ionhs/Escornabot-2.12/Software/arduino-1.4.3/arduino-1.4.3/README.md

# Arduino firmware for Escornabot



This is the Arduino firmware to upload to the Escornabot.

__More info about the Escornabot at [escornabot.com][ESC01]__

Please, [open issues here][ISS01] if you find any problem with this firmware. Thank you!

## Download

Download the __[last version from here](https://github.com/escornabot/arduino/releases/latest)__

It is preconfigured to run with the last stable [EscornaCPU board][ELE01]. If 
you don't have one or you are not sure, copy the most appropriate 
_Configuration.h_ from [_config_ subdirectories](config). 

    cp config/<escornaboard>/Configuration.h Escornabot/Configuration.h

Please, send us other board configurations if you have produced your own
electronic board and it is publicy available.

## Instructions

### Full guide

To configure and load the firmware, please, follow the [official guide][GUI01].

### Compilation and upload with PlatformIO

You only need to install [PlatformIO CLI][PIO01]:

    pip install -U platformio

There is a project file _platformio.ini_ to compile and upload escornabot
firmware to the Atmel AVR platform + Arduino framework for Arduino Nano and
Arduino Micro boards.

#### Arduino Nano

    # compile firmware and upload firmware to an Arduino Nano:
    pio run -e nano -t upload

#### Arduino Micro

    # compile firmware and upload firmware to an Arduino Micro:
    pio run -e micro -t upload

#### More boards

Please, send us new configurations if you test Escornabot in another board :)

## Branches and releases

Escornabot's repository flows through 2 main branches: 

- [stable][STA01]: well-tested firmware that you usually have to work with.
  Released versions are named with even minor numbers (x.0, x.2, ...).
- [testing][TES01]: new features and minor bugs pending of testing in deep.
  Released versions are named with odd minor numbers (x.1, x.3, ...).

<!-- links -->
[ELE01]: https://github.com/escornabot/electronics
[BRI01]: https://github.com/escornabot/arduino/releases/tag/v1.2-brivoi
[ESC01]: http://escornabot.com
[GUI01]: http://escornabot.com/web/en/content/configure-and-load-firmware
[ISS01]: https://github.com/escornabot/arduino/issues
[PIO01]: http://platformio.org/get-started/cli
[PLA01]: https://github.com/escornabot/arduino/releases/tag/v1.1-placidus
[STA01]: https://github.com/escornabot/arduino/tree/stable
[TES01]: https://github.com/escornabot/arduino/tree/testing
[VER201606]: https://github.com/escornabot/arduino/releases/tag/v1.3.1
[VER201608]: https://github.com/escornabot/arduino/releases/tag/v1.3.2
