ionhs/Escornabot-2.12/Recopilación/escornabot-v2.12-master (1)/escornabot-v2.12-master/README.md

# escornabot-v2.12 
  
En este repositorio encontrarás lo necesario para poder fabricar la versión v2.12 con la placa creada por XDeSIG. Es la evolución de la versión DIY.

Material recopilado de [Rafa Couto](https://github.com/rafacouto) y [XDeSIG](https://github.com/xdesig)
  
Web oficial del robot escornabot http://escornabot.com
  


# Piezas Impresas3D Necesarias
  
Descripción         | imagen          | archivo         
------------- | ------------- | ------------- 
Sujeción bola v2|ballcaster-v2.stl | [ballcaster-v2.stl](archivos-stl/ballcaster-v2.stl)  
Sujeción batería|battery-bracket.stl | [battery-bracket.stl](archivos-stl/battery-bracket.stl)  
Sujeción motores|MotorBracket.stl | [MotorBracket.stl](archivos-stl/MotorBracket.stl)   
Sujeción placa botonera|escornacpu-2_10-bracket.stl | [escornacpu-2_10-bracket.stl](archivos-stl/Addon-KeypadBracket-PCB.stl)  
Rueda izquierda|wheel-l.stl | [wheel-l.stl](archivos-stl/wheel-l.stl)  
Rueda derecha|wheel-r.stl | [wheel-r.stl](archivos-stl/wheel-r.stl)

# Guía soldadura componentes
  
Para esta versión tienes una guía de soldadura creada por XDeSIG donde puedes ver cada componente en tres idiomas:

- [Guía Gallego](https://drive.google.com/file/d/0B8qe5ux0eH6Ca1RxaEpXN0RBNzQ/view) 
- [Guía Castellano](https://drive.google.com/file/d/1LsLHT4FGi4LXgHwbQ9Av0ggsQkUQL7MU/view)  
- [Guía Catalán](https://drive.google.com/file/d/1ZNXCGC65Pyris7Z-aMvKBDYPzR_YNUv_/view)  

Si eres de los que no les gusta complicarse, puedes pedir tu kit abriendo un tema nuevo en el grupo de google, te dejo link donde XDeSIG explica las diferentes opciones que tienes [pincha aquí](https://groups.google.com/forum/#!topic/escornabot_users/paQGTPHzNTQ)
  
  

# Guía montaje
  
También tienes un .pdf para descargar la [guía de montaje del cuerpo](https://goo.gl/3XQ8nM)

# Características de la placa
  
Los más curiosos pueden consultar todas las [características de la placa](https://drive.google.com/file/d/0B8qe5ux0eH6CQ1dsNGh2UFJvdnNqRUhfakRvUjZVejFtQ2dF/view)  
  
