ionhs/Escornabot-2.12/Boom.md

| Componente | nº | Link | Observaciónes | Comprado |
| --- | ---- | --- | --- | --- |
| Motor 28BYJ-48 (sin ULN2003 driver) | 2 | https://es.aliexpress.com/item/Frees-hipping-5V-4-Phase-Stepper-Step-Motor-Driver-Board-ULN2003-with-drive-Test-Module-Machinery/32706559510.html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 | Para la versión 2.12 no hace falta comprar el driver ULN2003 | Sí |
| Cable USB | 1 | | Cable Mini-B USB >> USB | No |
| Diodo Schottky | 1 | https://es.aliexpress.com/item/1N4007-1N4148-1N5819-1N5399-1N5408-1N5822-FR107-FR207-8-valores-100-piezas-componentes-electr-nicos-paquete/32856981814.html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 | La mayoría de los diodos valen. Algunos han usado el 1N4007 que no es Schottky | Sí |
| Arduino NANO Atmega328 | 1 | https://es.aliexpress.com/item/Nano-V3-ATmega328-CH340G-Micro-USB-Pin-headers-NOT-soldered-Compatible-for-Arduino-Nano-V3-0/32664577152.html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 | Es el diseño RobotDyn que lleva un regulador de 3.3v | Sí |
| Buzzer 5V | 1 | https://es.aliexpress.com/item/Free-Shipping-10pcs-Electromagnetic-buzzer-5V-5V-active-buzzer/635190995.html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 | | Sí |
| Interruptor SK-12D07 o SK-12F14 | 1 | https://es.aliexpress.com/item/Nueva-llegada-10-unids-lote-interruptor-SK12D07VG3-Stents-peque-o-interruptor-de-palanca-3mm-alta-miniatura/32918136229.html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 | Cualquiera de los 2 interruptores valen, este es el SK12D07  | Sí |
| Fusible autoarmable RXEF050 XF050 72v 0.5A | 1 | https://es.aliexpress.com/item/10-PCSlot-fusible-recuperaci-n-auto-RXEF050-XF050-72-v-0-5A-PPTC/32896526801.html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 | | Sí |
| Tiras de 40 pines machos/hembras | 2 | https://es.aliexpress.com/item/Promotion-5-PCS-Pack-40-Pin-2-54mm-Single-Row-Straight-Male-Female-Pin-Header-Strip/32598438788.html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 | | Sí |
| ULN2803 | 1 | https://es.aliexpress.com/item/10pcs-lot-ULN2803APG-ULN2803-DIP-18-Octal-High-Voltage-High-Current-Darlington-Transistor-Arrays/32817793114.html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 | | Sí |
| Zócalo DIP-18 | 1 | https://es.aliexpress.com/item/10pcs-Round-Hole-18-Pins-2-54MM-DIP-18-PIN-IC-Sockets-Adaptor-Solder-Type-IC/32805504735.html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 | Con las patas redondeadas es más robusto | Sí |
| Pulsadores con botón colores (blanco, negro, rojo, verde y azul) | 5 | https://es.aliexpress.com/item/100pcs-Plastic-Tactile-Switch-PCB-Tact-Push-Button-Momentary-Switch-4-Pins-5-Color-Button-Cap/32826994795.html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 | OJO han envio amarillo en vez de negro. Tras reclamar/pelearlo ha devuelto 1 dolar. | Sí |
| Led diodos 3mm (blanco, rojo, verde y azul) | 4 | https://es.aliexpress.com/item/500pcs-3-mm-Super-Bright-High-Brightness-5-Colors-Red-Green-Blue-Yellow-White-Mini-Diffused/1936229691.html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 | | Sí |
| Conectores macho XH2.54 de 2 pines | 2 | https://es.aliexpress.com/item/XH2-54-conector-pin-Header-macho-material-2-54mm-pitch-XH-A-2-P-3-P/32848821355.html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 | | Sí |
| Condensadores 100nF | 2 | | El encapsulado debe ser del tipo lenteja pequeña para que encaje. Al no tener he puesto smd | No |
| Resistencia 1K | 4 | | 0,25w | No |
| Resistencia 10K | 8 | | 0,25w | No |
| Resistencia 18K | 1 | | 0,25w | No |
| Resistencia 22K | 1 | | 0,25w | No |
| Conector 2 pines con tornillo | 1 | | Las dimensiones de los pads son raras para ese tipo de conector. He tenido que poner un molex de 90º que tenía | No |
| Jumper 2 pines 2.54 | 1 | https://es.aliexpress.com/store/product/100pcs-Pin-Header-Jumper-blocks-Connector-2-54-mm-for-3-1-2-Hard-Disk-Drive/4388017_32907886777.html | | No |
| Tornillos M3x5 | ? | | | No |
| Tornillos M3x15 | ? | | | No |
| Tuerca M3 | 2 | | | No |
| Portapilas R6 4 pilas AA | 1 | https://www.ebay.es/itm/PORTAPILAS-4x-2-2-AA-R6-6v-con-cable-alimentacion-PCB-battery-holder/321578227852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 | | Si |
| Canica diametro 14mm | 1 | https://es.aliexpress.com/item/40-pcs-14mm-Mixed-Smiling-Face-Smile-Round-Ball-Spacer-Beads-Plastic-Acrylic-For-DIY-Necklace/32699472196.html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 | Aunque son bolas para bisutería funcionan bien | Si |
| Junta tórica 63x57x3mm | 2 | https://es.aliexpress.com/item/Electronic-Component-Red-O-Ring-62mm-x-56mm-x-3mm-O-Ring-Washer-Seals-Assortment/32371865042.html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 | | Si |
| PCB escornabot 2.12 | 1 | | | Si |
