ionhs/Escornabot-2.12/Recopilación/electronics-master (2)/electronics-master/providers/PCBWay.pdf

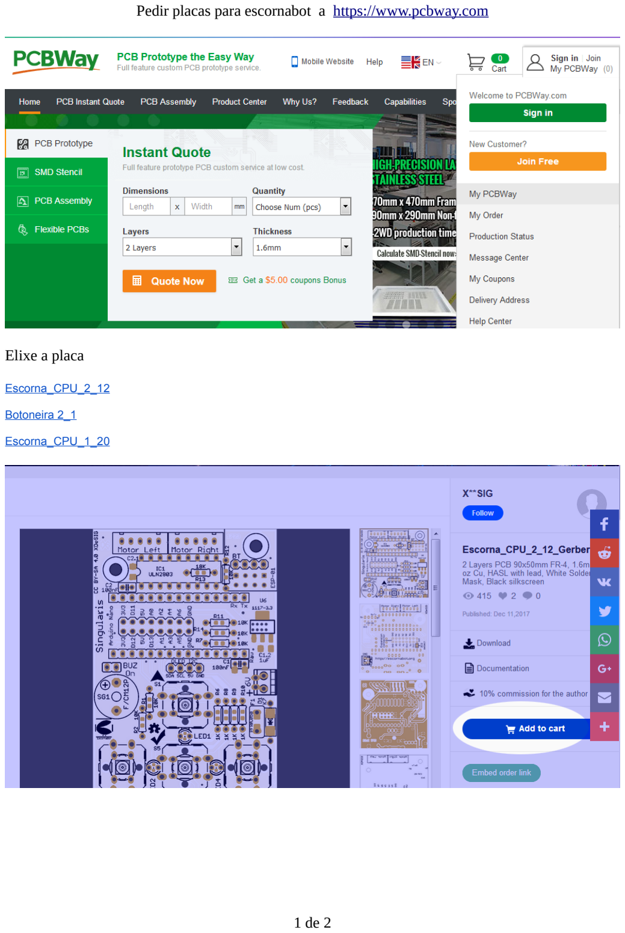
[picture p12: page 1]

Pedir placas para escornabot a https://www.pcbway.com

Elixe a placa

Escorna_CPU_2_12 (https://www.pcbway.com/project/shareproject/W50475ASN19_Escorna_CPU_2_12_Gerber.html)

Botoneira 2_1 (https://www.pcbway.com/project/shareproject/W50475ASN5_Escorna_bot_2_1_Gerber.html)

Escorna_CPU_1_20 (https://www.pcbway.com/project/shareproject/W50475ASN23_Escorna_CPU_1_20.html)

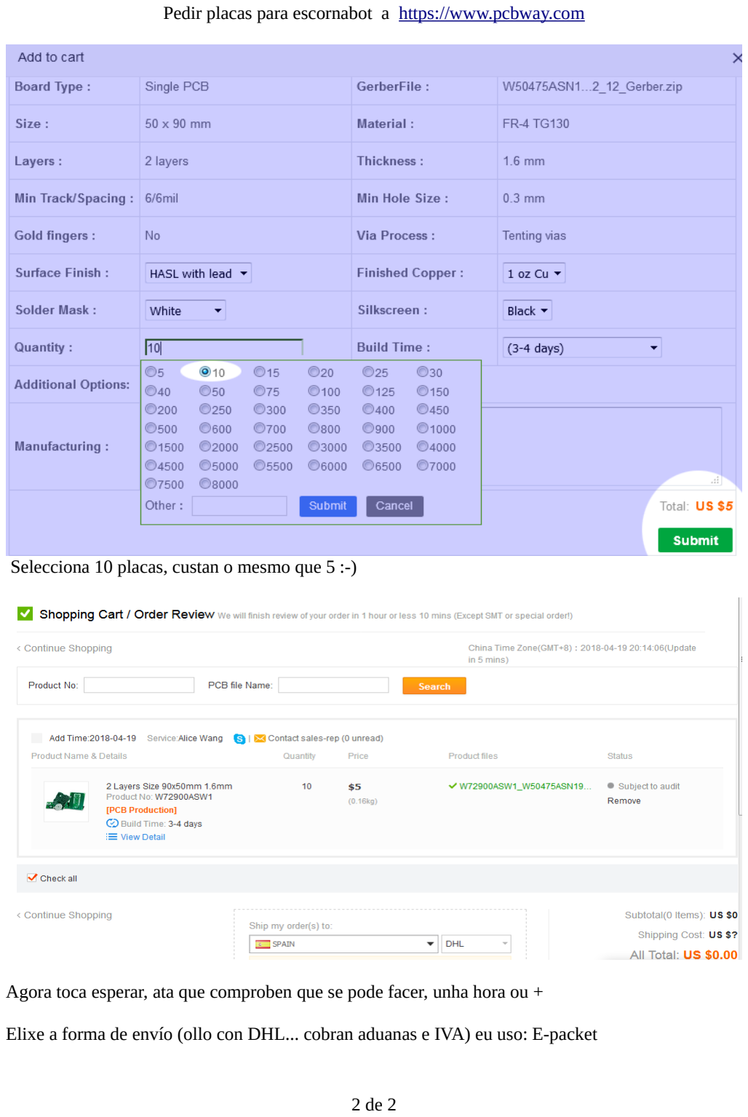
[picture p13: page 2]

Pedir placas para escornabot a https://www.pcbway.com

Selecciona 10 placas, custan o mesmo que 5 :-)

Agora toca esperar, ata que comproben que se pode facer, unha hora ou +

Elixe a forma de envío (ollo con DHL... cobran aduanas e IVA) eu uso: E-packet
