ionhs/Escornabot-2.12/Recopilación/electronics-master (2)/electronics-master/Keypad/E_KEYPAD_2.0D/Escorna_Shield_botoneira_2_0D_CI_bot.pdf

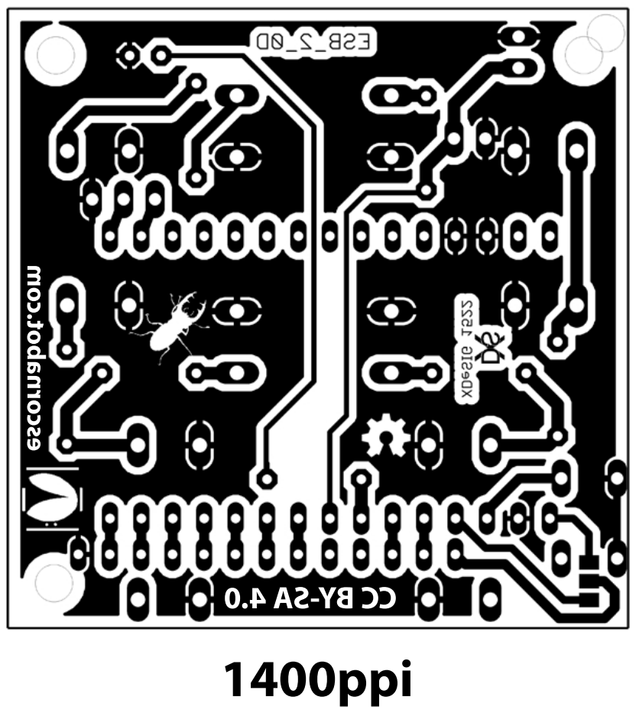
[picture p25: page 1]

escornabot.com

1

4

0

0

p

p

i
