ionhs/Escornabot-2.12/Recopilación/electronics-master (2)/electronics-master/EscornaCPU/2.x/2.01/Escorna_CPU_2_01_Photolit.pdf

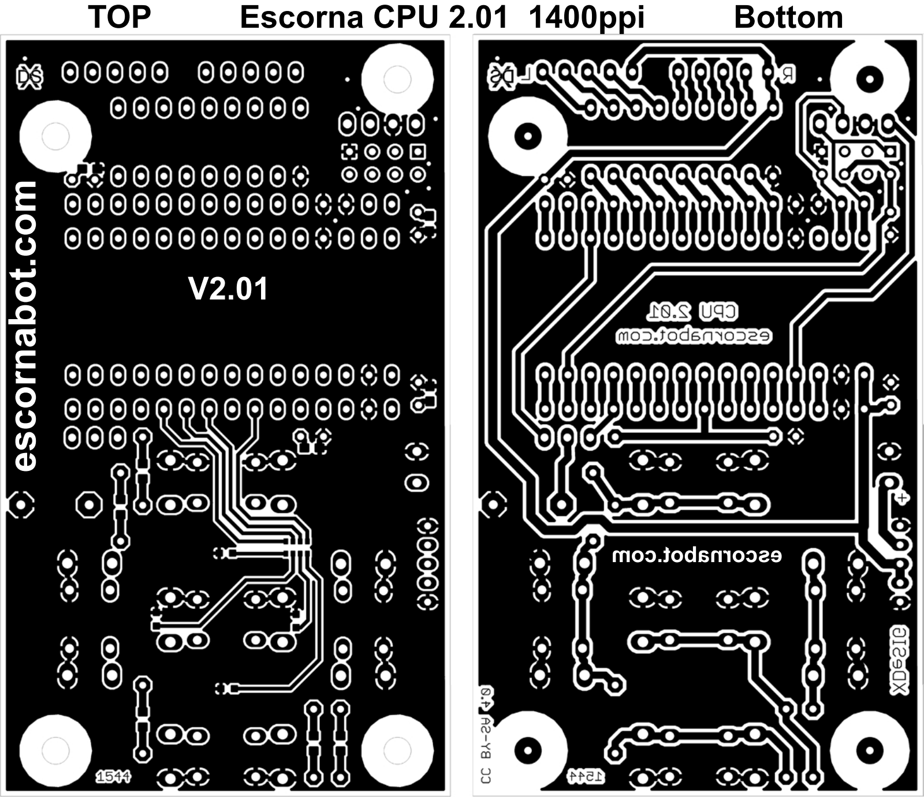
[picture p26: page 1]

e

s

c

orn

a

b

ot.c

o

m

TOP | EscornaCPU2.011400ppi | Bottom

V2.01
