ionhs/Escornabot-2.12/imagenes/ballcaster-v2.png

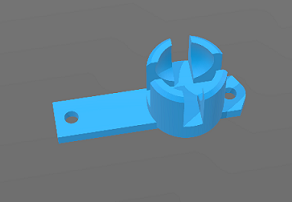
imagenes/ballcaster-v2.png
