ionhs/Escornabot-2.12/imagenes/battery-bracket.png

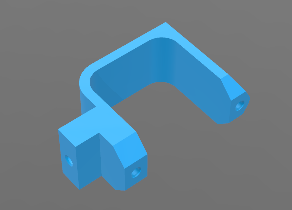
imagenes/battery-bracket.png
