ionhs/Escornabot-2.12/imagenes/escornabot-v212.jpg

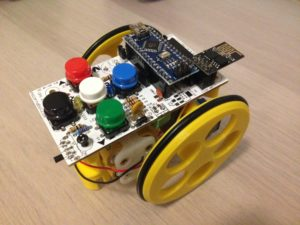
imagenes/escornabot-v212.jpg
