ionhs/Escornabot-2.12/imagenes/escornacpu-2_10-bracket.png

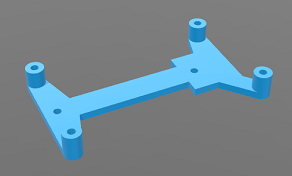
imagenes/escornacpu-2_10-bracket.png
