ionhs/Escornabot-2.12/imagenes/MotorBracket.png

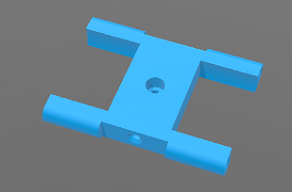
imagenes/MotorBracket.png
