ionhs/Escornabot-2.12/imagenes/piezas-v212.JPG

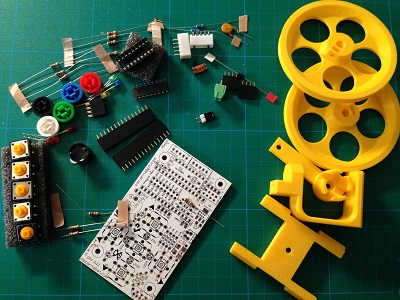
imagenes/piezas-v212.JPG
