ionhs/Escornabot-2.12/imagenes/placas-v212.jpg

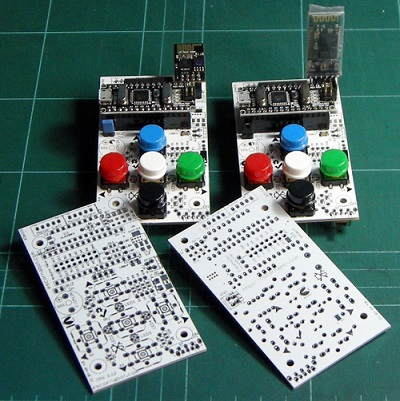
imagenes/placas-v212.jpg
