ionhs/Escornabot-2.12/imagenes/wheel-l.png

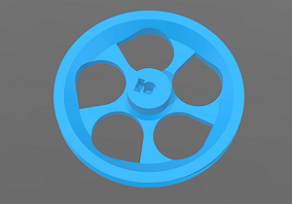
imagenes/wheel-l.png
