ionhs/Escornabot-2.12/imagenes/wheel-r.png

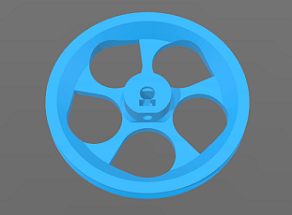
imagenes/wheel-r.png
