ionhs/Escornabot-2.12/Recopilación/electronics-master (2)/electronics-master/ArduinoShield/BotMotShielArdu.jpg

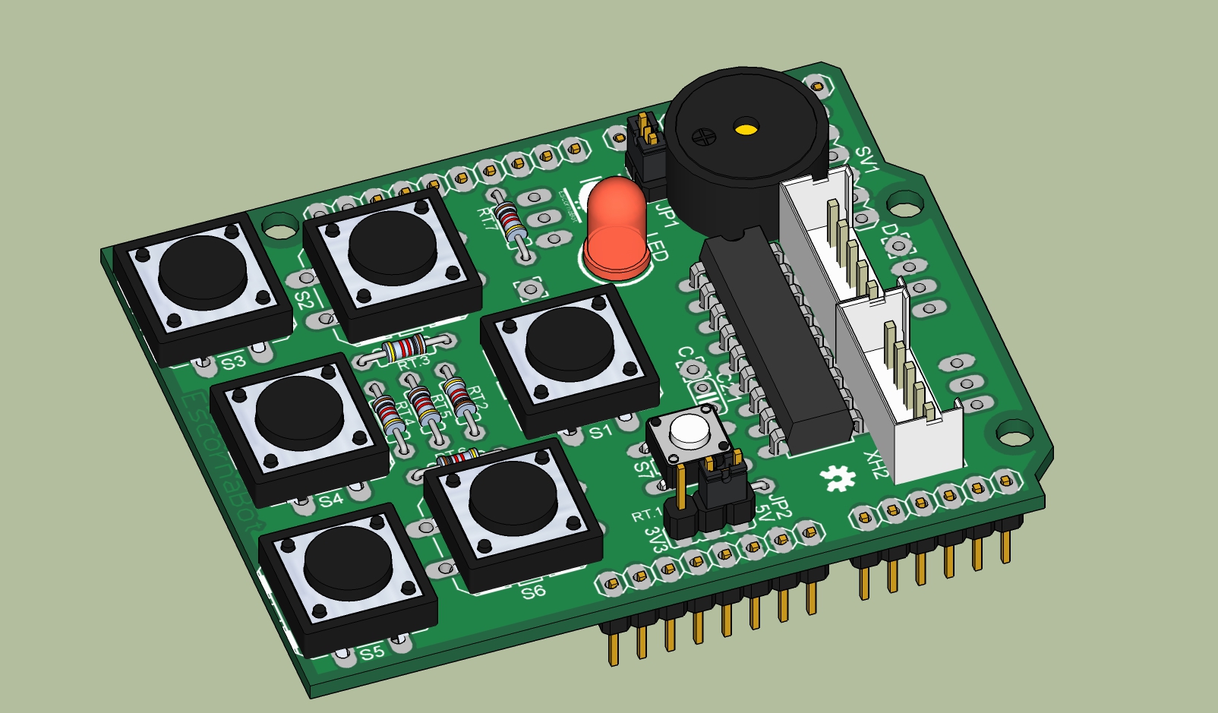
Recopilación/electronics-master (2)/electronics-master/ArduinoShield/BotMotShielArdu.jpg
