ionhs/Escornabot-2.12/Recopilación/electronics-master (2)/electronics-master/ArduinoShield/BotMotShielArdu_serig.png

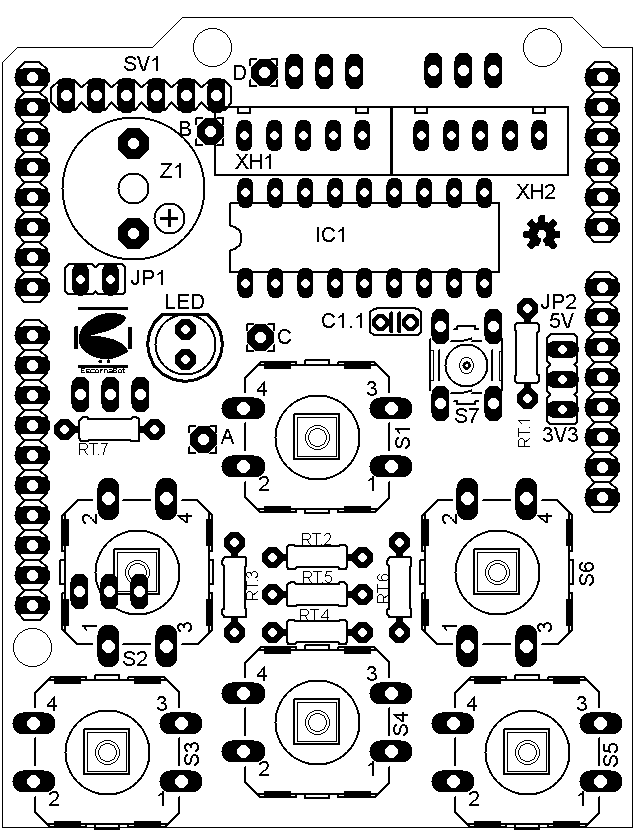
Recopilación/electronics-master (2)/electronics-master/ArduinoShield/BotMotShielArdu_serig.png
