ionhs/Escornabot-2.12/Recopilación/electronics-master (2)/electronics-master/Cervus/Cervus_2_0.jpg

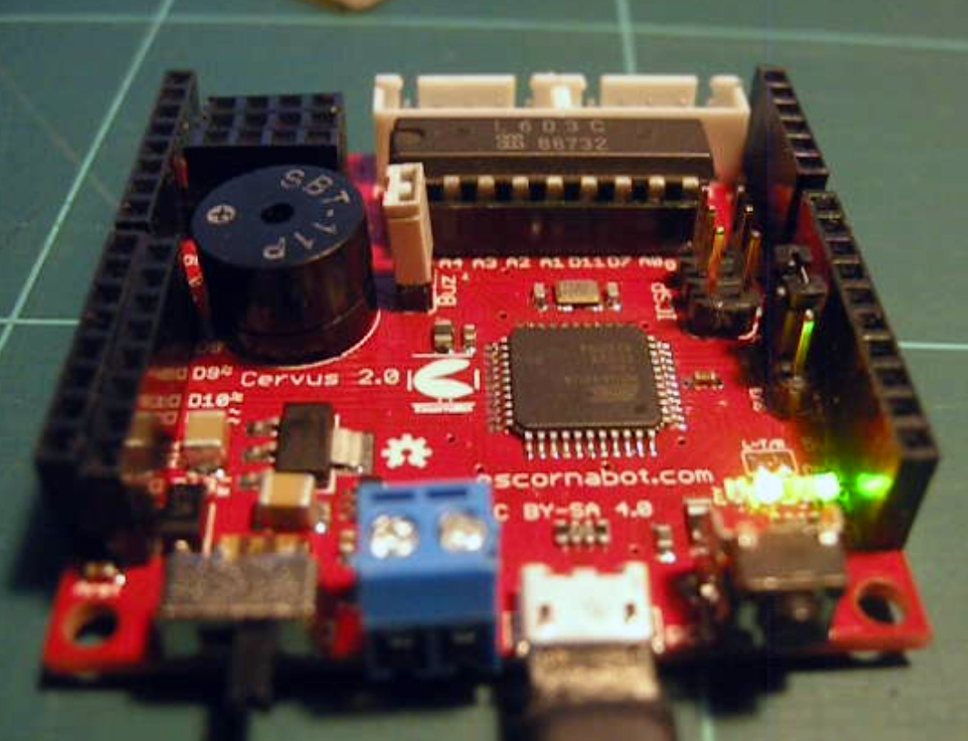
Recopilación/electronics-master (2)/electronics-master/Cervus/Cervus_2_0.jpg
