ionhs/Escornabot-2.12/Recopilación/electronics-master (2)/electronics-master/Cervus/cervus_2_0_BOT_Sim.png

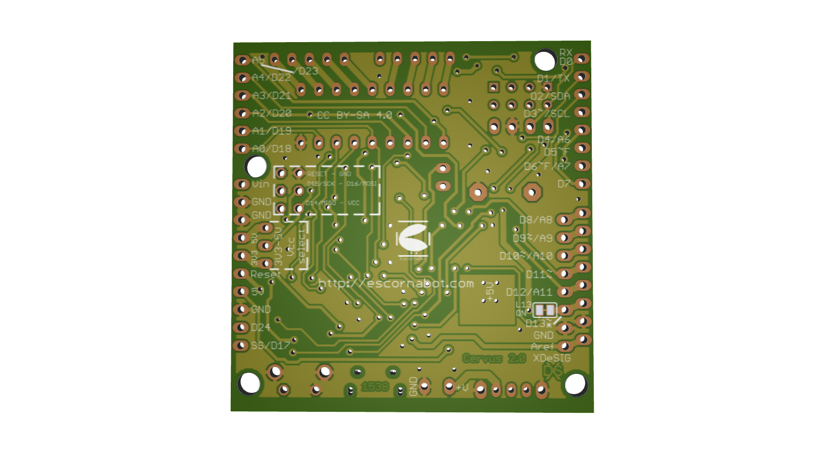
Recopilación/electronics-master (2)/electronics-master/Cervus/cervus_2_0_BOT_Sim.png
