ionhs/Escornabot-2.12/Recopilación/electronics-master (2)/electronics-master/Cervus/cervus_2_0_Sim3_4.jpg

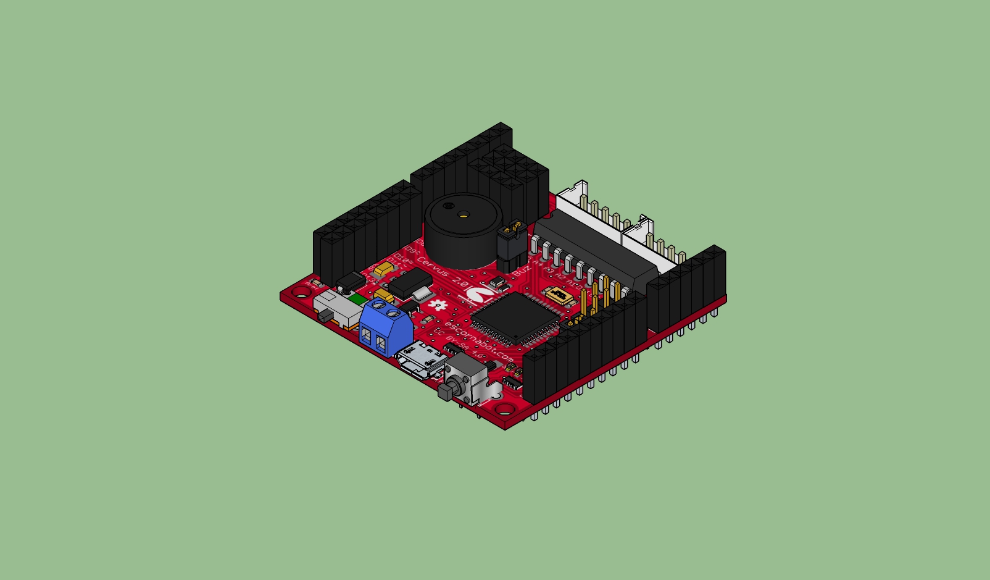
Recopilación/electronics-master (2)/electronics-master/Cervus/cervus_2_0_Sim3_4.jpg
