ionhs/Escornabot-2.12/Recopilación/electronics-master (2)/electronics-master/Cervus/cervus_2_0_Sim4_3.jpg

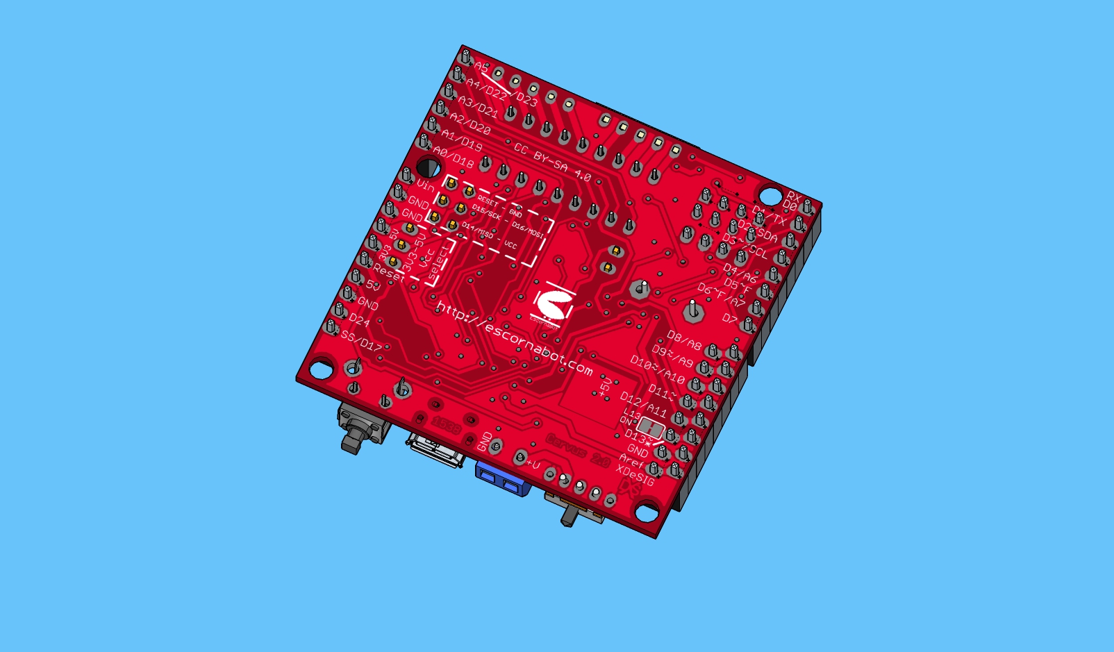
Recopilación/electronics-master (2)/electronics-master/Cervus/cervus_2_0_Sim4_3.jpg
