ionhs/Escornabot-2.12/Recopilación/electronics-master (2)/electronics-master/EscornaCPU/1.x/1.0/Escorna_CPU_1_0 -BotoneiraShield_2_0.jpg

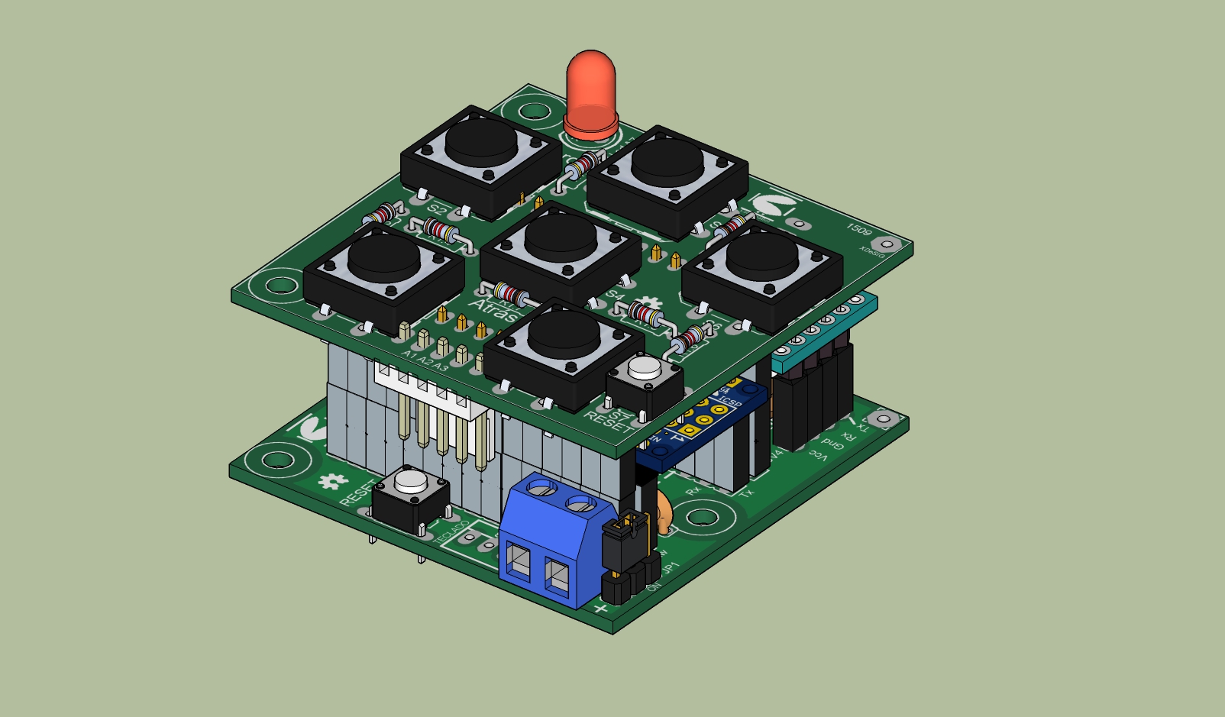
Recopilación/electronics-master (2)/electronics-master/EscornaCPU/1.x/1.0/Escorna_CPU_1_0 -BotoneiraShield_2_0.jpg
