ionhs/Escornabot-2.12/Recopilación/electronics-master (2)/electronics-master/EscornaCPU/1.x/1.0/Escorna_CPU_1_01_layer.png

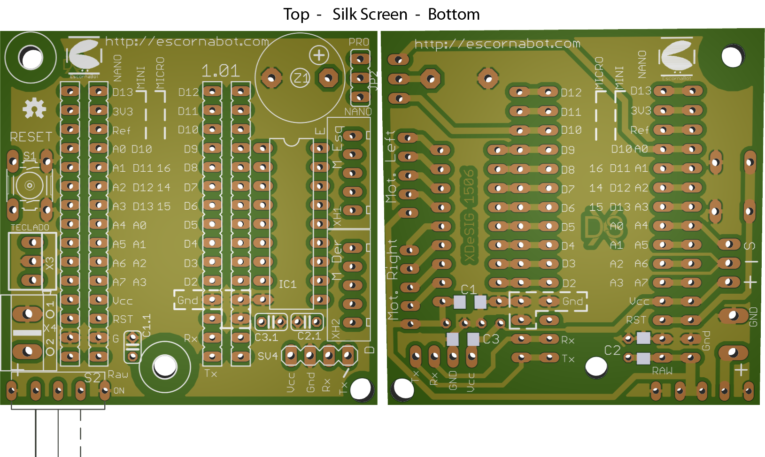
Recopilación/electronics-master (2)/electronics-master/EscornaCPU/1.x/1.0/Escorna_CPU_1_01_layer.png
