ionhs/Escornabot-2.12/Recopilación/electronics-master (2)/electronics-master/EscornaCPU/1.x/1.20/Escorna_CPU_1_20.jpg

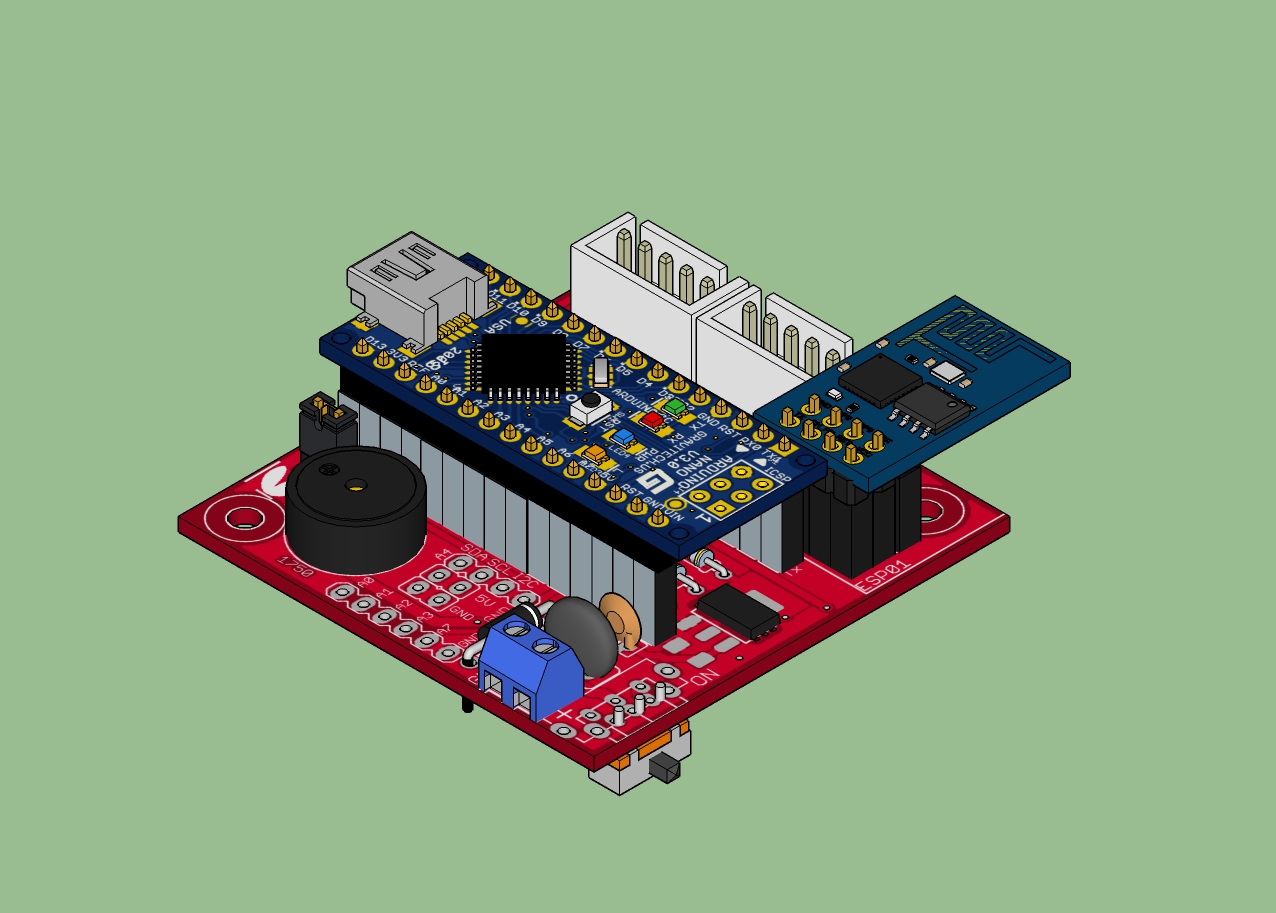
Recopilación/electronics-master (2)/electronics-master/EscornaCPU/1.x/1.20/Escorna_CPU_1_20.jpg
