ionhs/Escornabot-2.12/Recopilación/electronics-master (2)/electronics-master/EscornaCPU/2.x/2.01/Escorna_CPU_2_01_34B.jpg

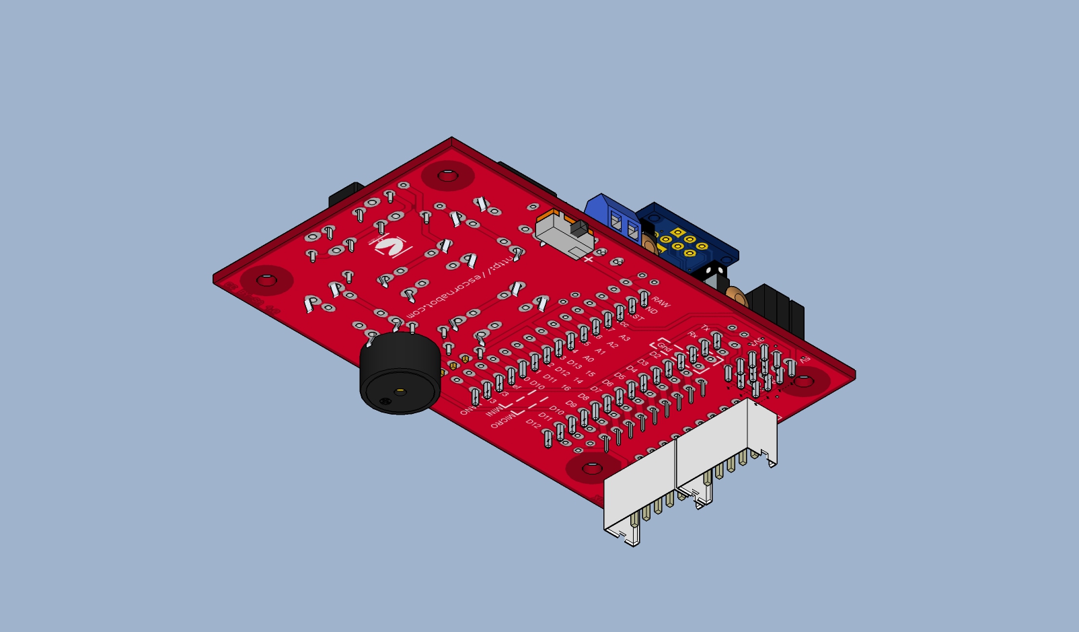
Recopilación/electronics-master (2)/electronics-master/EscornaCPU/2.x/2.01/Escorna_CPU_2_01_34B.jpg
