ionhs/Escornabot-2.12/Recopilación/electronics-master (2)/electronics-master/EscornaCPU/2.x/2.10/Escorna_CPU_2_10_Bottom.png

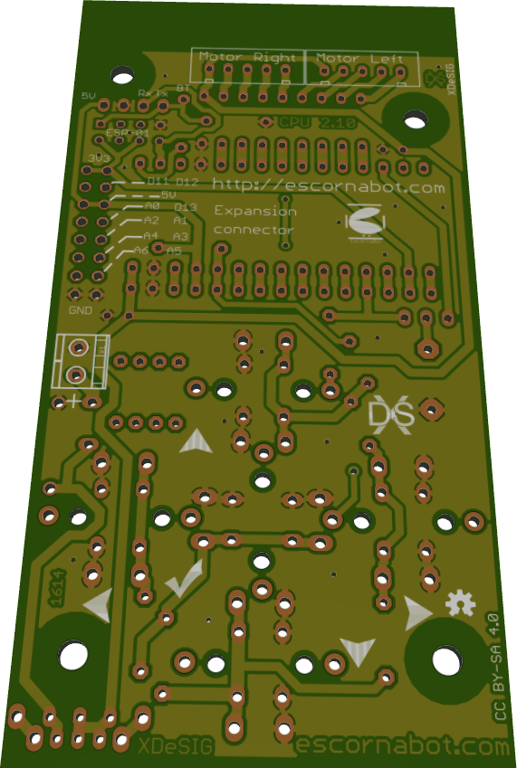
Recopilación/electronics-master (2)/electronics-master/EscornaCPU/2.x/2.10/Escorna_CPU_2_10_Bottom.png
