ionhs/Escornabot-2.12/Recopilación/electronics-master (2)/electronics-master/EscornaCPU/2.x/2.12/image1.png

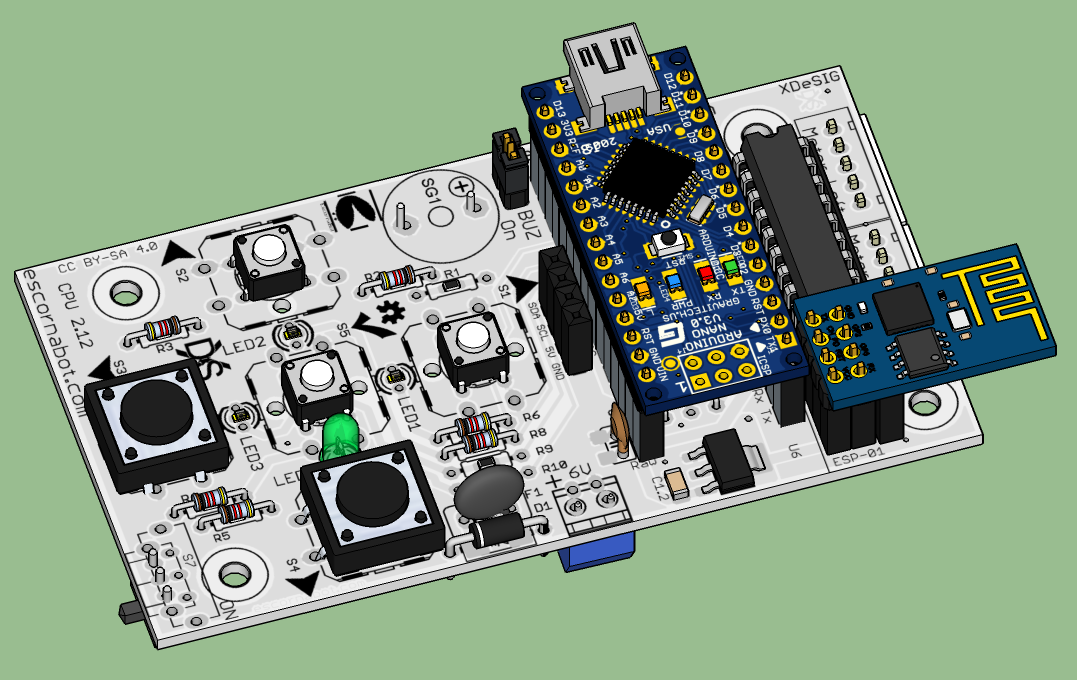
Recopilación/electronics-master (2)/electronics-master/EscornaCPU/2.x/2.12/image1.png
