ionhs/Escornabot-2.12/Recopilación/electronics-master (2)/electronics-master/EscornaCPU/2.x/2.20/Escorna_CPU_2_20_Top.png

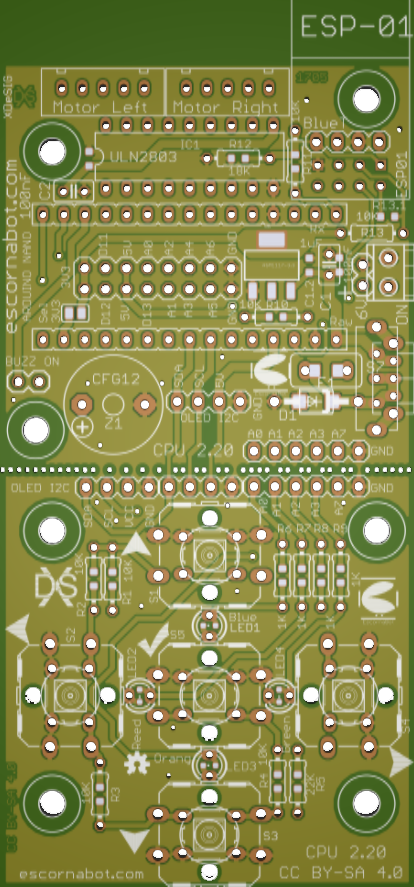
Recopilación/electronics-master (2)/electronics-master/EscornaCPU/2.x/2.20/Escorna_CPU_2_20_Top.png
