ionhs/Escornabot-2.12/Recopilación/electronics-master (2)/electronics-master/Keypad/E_KEYPAD_2.0D/Escorna_Shield_botoneira_2_0D_mont.jpg

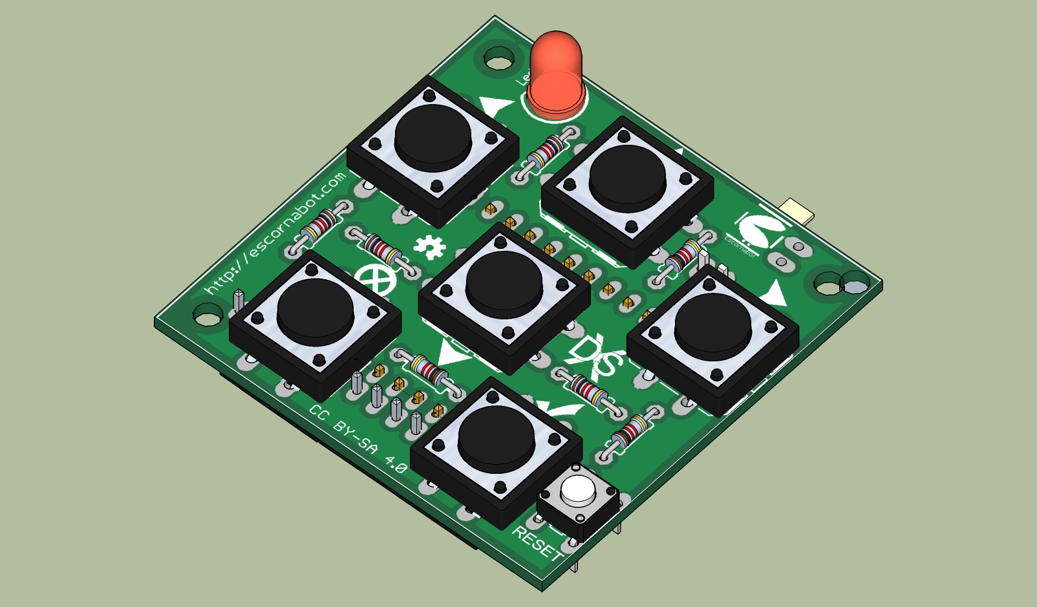
Recopilación/electronics-master (2)/electronics-master/Keypad/E_KEYPAD_2.0D/Escorna_Shield_botoneira_2_0D_mont.jpg
