ionhs/Escornabot-2.12/Recopilación/electronics-master (2)/electronics-master/Keypad/E_KEYPAD_2.1/E_KEYPAD_2.1.jpg

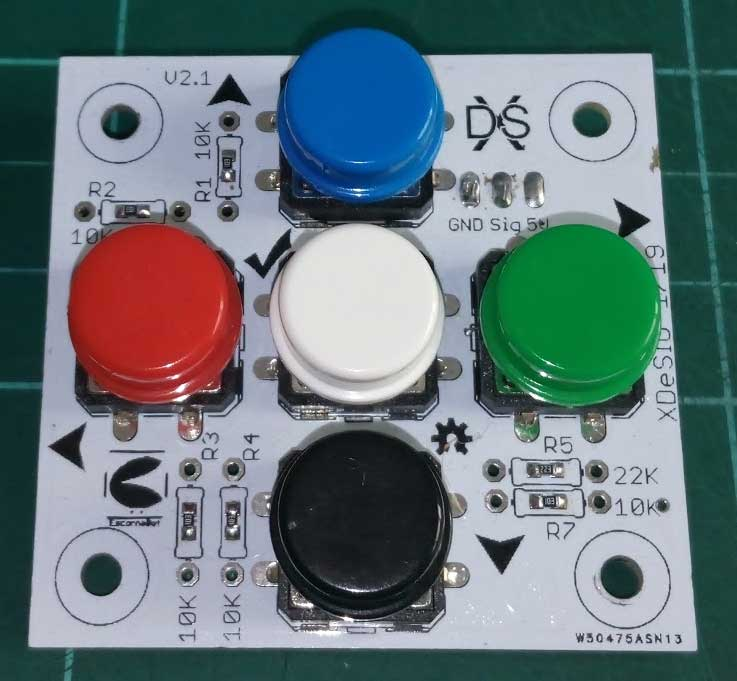
Recopilación/electronics-master (2)/electronics-master/Keypad/E_KEYPAD_2.1/E_KEYPAD_2.1.jpg
