ionhs/Escornabot-2.12/Recopilación/electronics-master (2)/electronics-master/Keypad/E_KEYPAD_2.1/eagleUp/eagleUp_E_KEYPAD__2_1_bottom.png

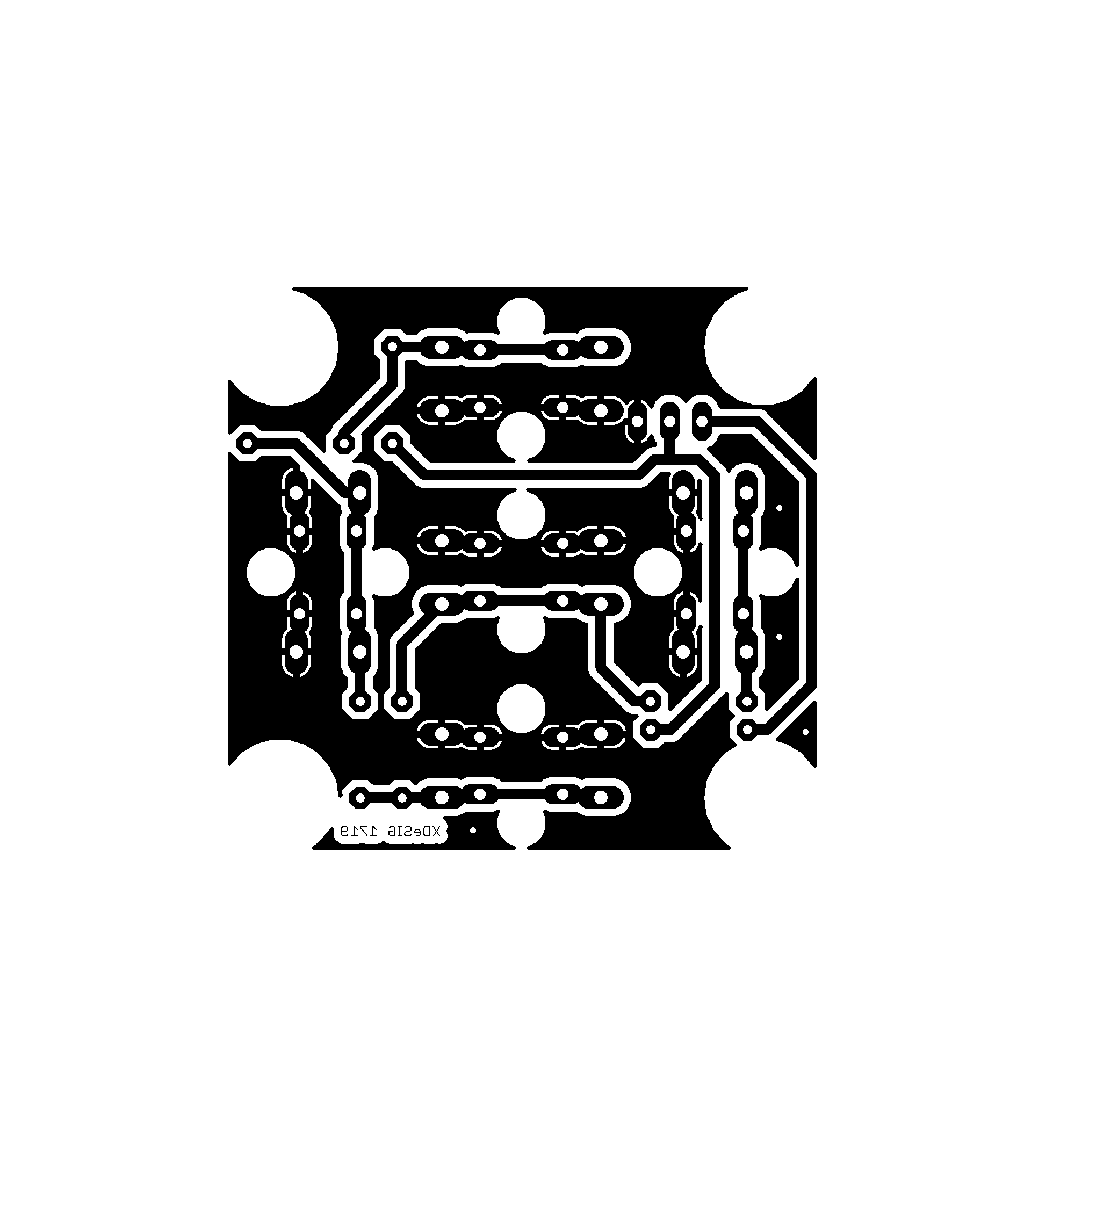
Recopilación/electronics-master (2)/electronics-master/Keypad/E_KEYPAD_2.1/eagleUp/eagleUp_E_KEYPAD__2_1_bottom.png
