ionhs/Escornabot-2.12/archivos-stl/battery-bracket.stl

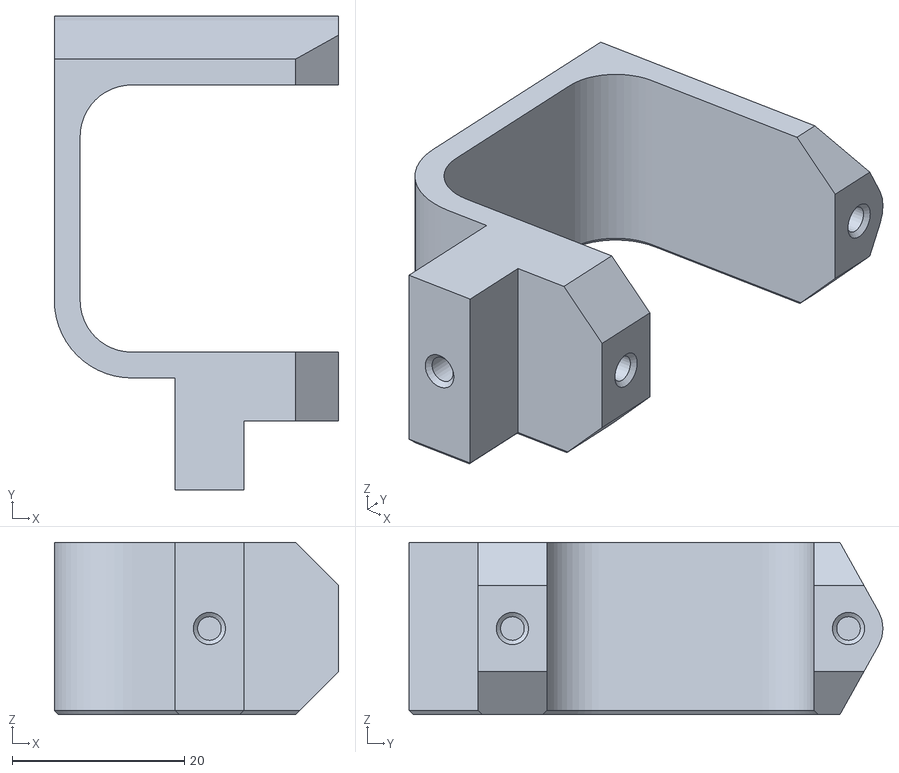
[picture p87: CAD file, 2018-10-16]
archivos-stl/battery-bracket.stl
33.0 x 55.0 x 20.0
