ionhs/Escornabot-2.12/Recopilación/electronics-master (2)/electronics-master/Cervus/cervus_2_0_TCream.dxf

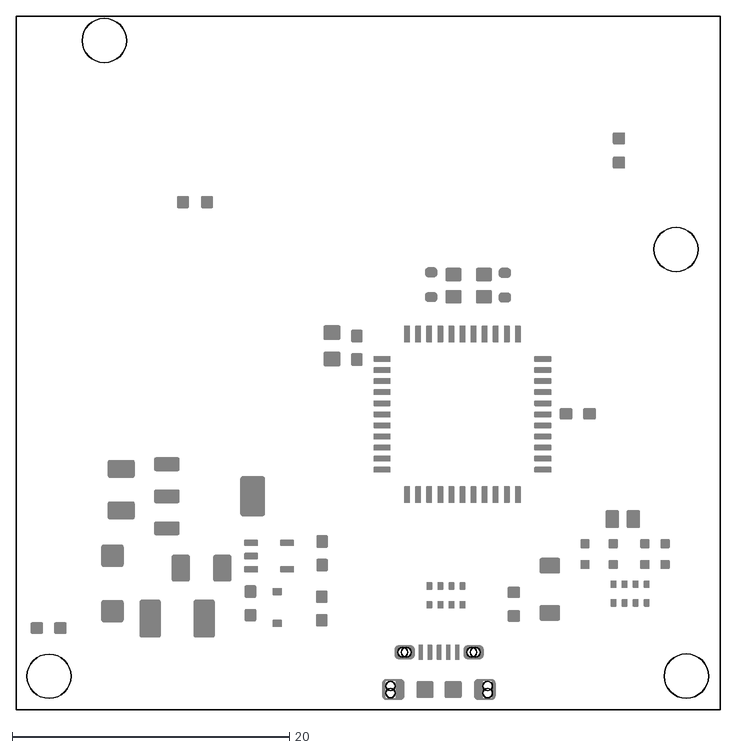
[picture p88: CAD file, 2018-10-16]
Recopilación/electronics-master (2)/electronics-master/Cervus/cervus_2_0_TCream.dxf
50.8 x 50.1
