ionhs/Escornabot-2.12/archivos-stl/wheel-r.stl

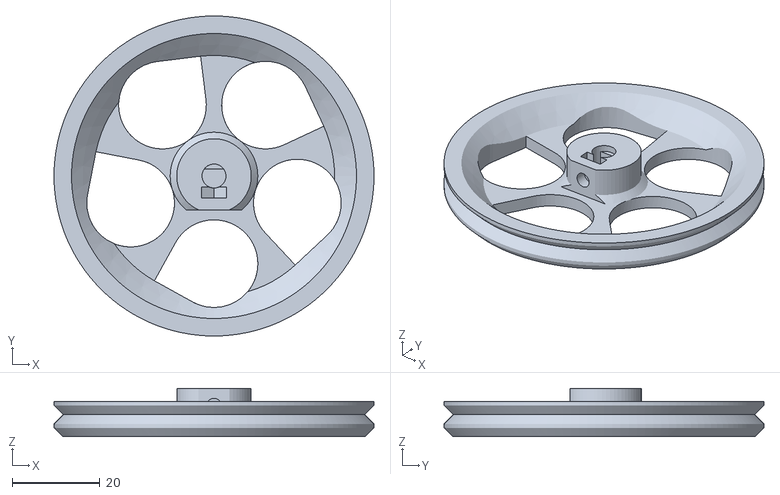
[picture p92: CAD file, 2018-10-16]
archivos-stl/wheel-r.stl
73.0 x 73.0 x 11.0
