ionhs/Escornabot-2.12/archivos-stl/escornacpu-2_10-bracket.stl

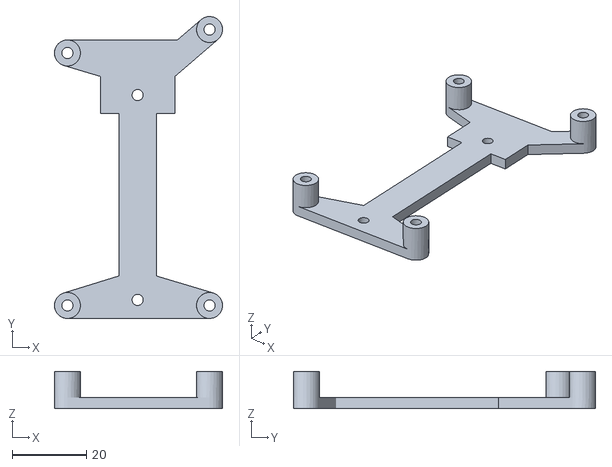
[picture p94: CAD file, 2018-10-16]
archivos-stl/escornacpu-2_10-bracket.stl
45.2 x 81.1 x 10.0
