ionhs/Escornabot-2.12/archivos-stl/MotorBracket.stl

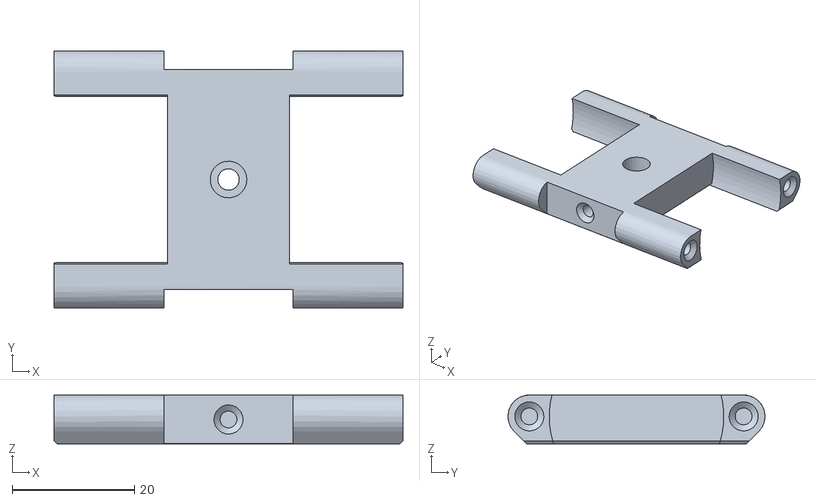
[picture p95: CAD file, 2018-10-16]
archivos-stl/MotorBracket.stl
57.0 x 42.0 x 8.00
