ionhs/Escornabot-2.12/archivos-stl/ballcaster-v2.stl

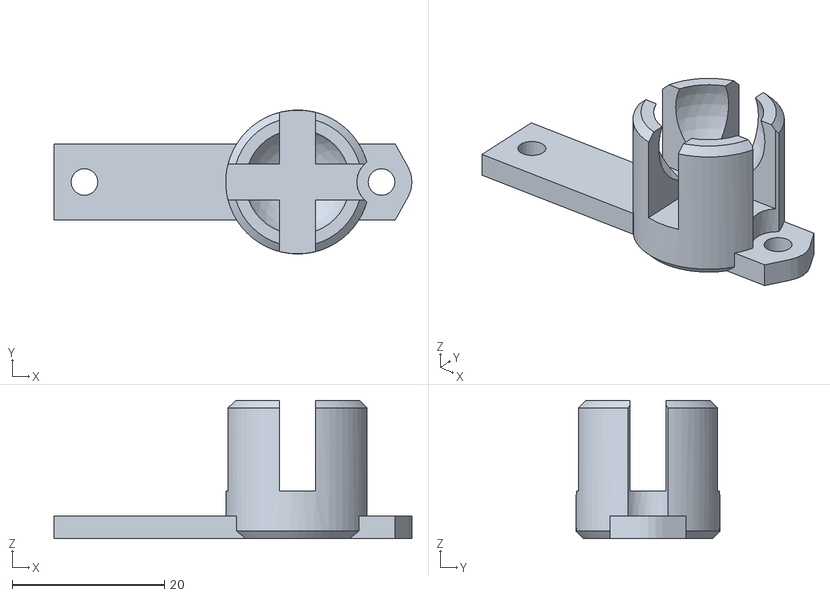
[picture p96: CAD file, 2018-10-16]
archivos-stl/ballcaster-v2.stl
47.0 x 18.9 x 18.2
