ionhs/Escornabot-2.12/(list of files, cad)

Other CAD files:
archivos-stl/wheel-l.stl
