ionhs/Escornabot-2.12/Recopilación/electronics-master (2)/electronics-master/ArduinoShield/BotMotShielArdu_BOT_result.png

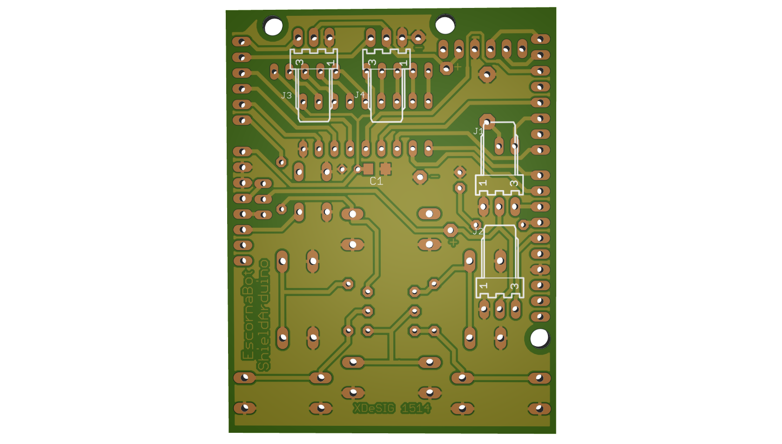
Recopilación/electronics-master (2)/electronics-master/ArduinoShield/BotMotShielArdu_BOT_result.png
