ionhs/Escornabot-2.12/Recopilación/electronics-master (2)/electronics-master/Keypad/E_KEYPAD_2.1/E_KEYPAD__2_1_Esq.pdf

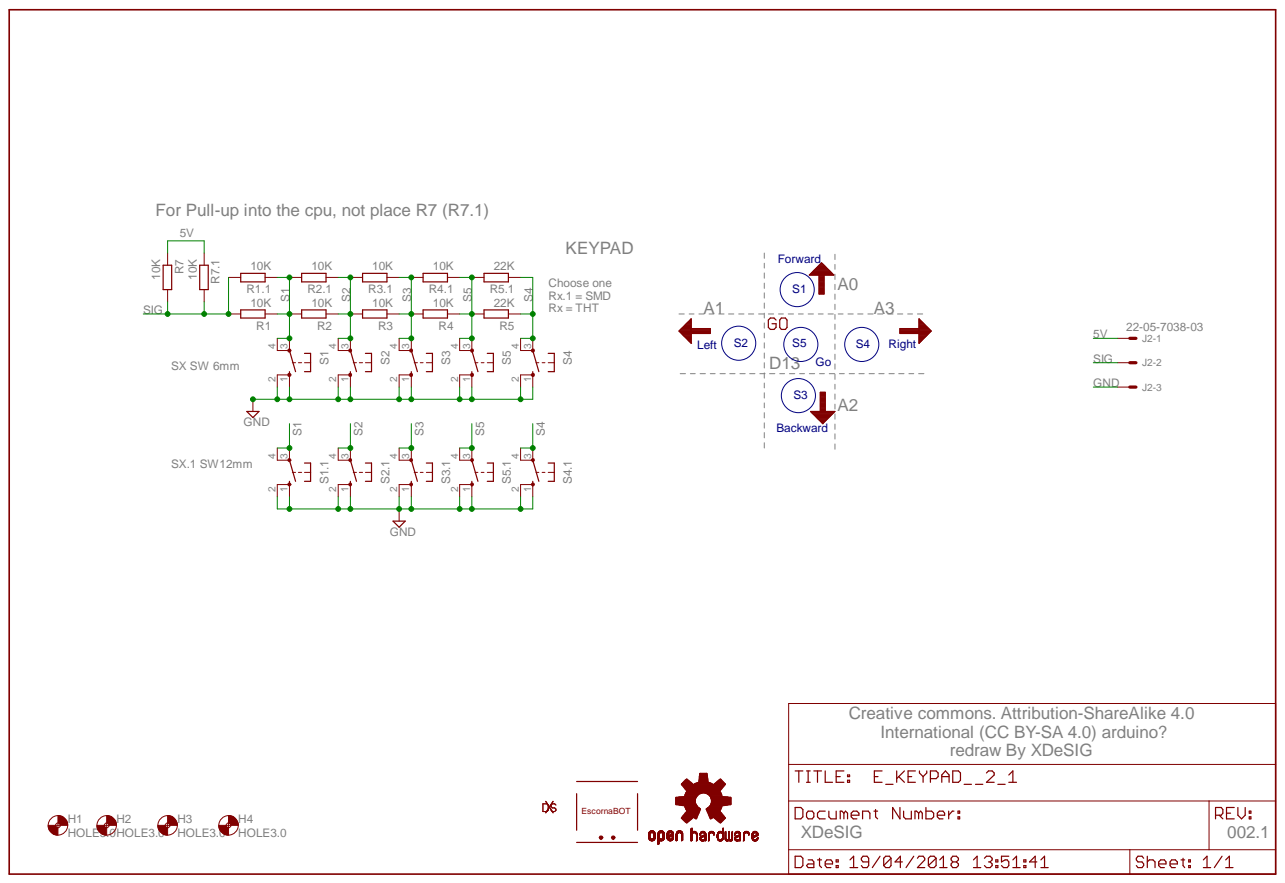
[picture p106: page 1]
Choose one Rx.1 = SMD Rx = THT; HOLE3.0; GND; HOLE3.0 HOLE3.0 HOLE3.0; XDeSIG; KEYPAD; SIG; EscornaBOT; Forward; Left; Right; Backward

For Pull-up into the cpu, not place R7 (R7.1)

Creative commons. Attribution-ShareAlike 4.0
International (CC BY-SA 4.0) arduino?

redraw By XDeSIG
