ionhs/Escornabot-2.12/Recopilación/electronics-master (2)/electronics-master/EscornaCPU/2.x/2.12/Escorna_CPU_2_12_ESQ.pdf

A0
A1

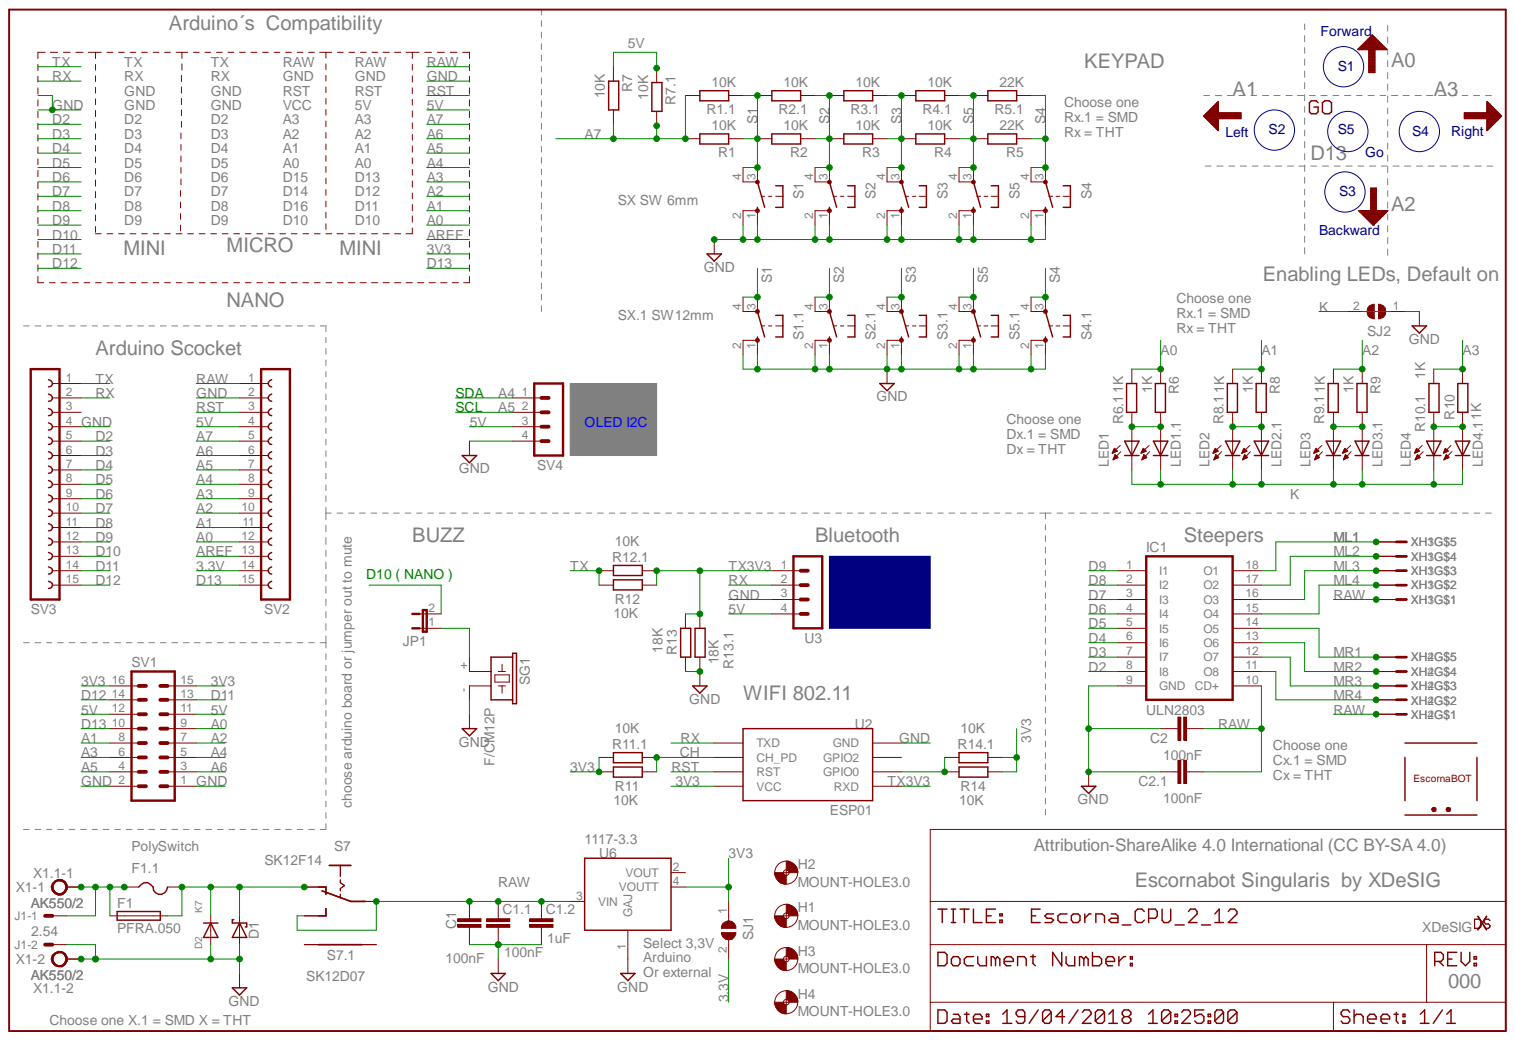
[picture p107: page 1]

Enabling LEDs, Default on

choose arduino board or jumper out to mute

Attribution-ShareAlike 4.0 International (CC BY-SA 4.0)

Escornabot Singularis by XDeSIG

Choose one X.1 = SMD X = THT
