ionhs/Escornabot-2.12/Recopilación/electronics-master (2)/electronics-master/Keypad/E_KEYPAD_2.1/E_KEYPAD__2_1.brd

## EAGLE design Recopilación/electronics-master (2)/electronics-master/Keypad/E_KEYPAD_2.1/E_KEYPAD__2_1.brd (2018-10-16)

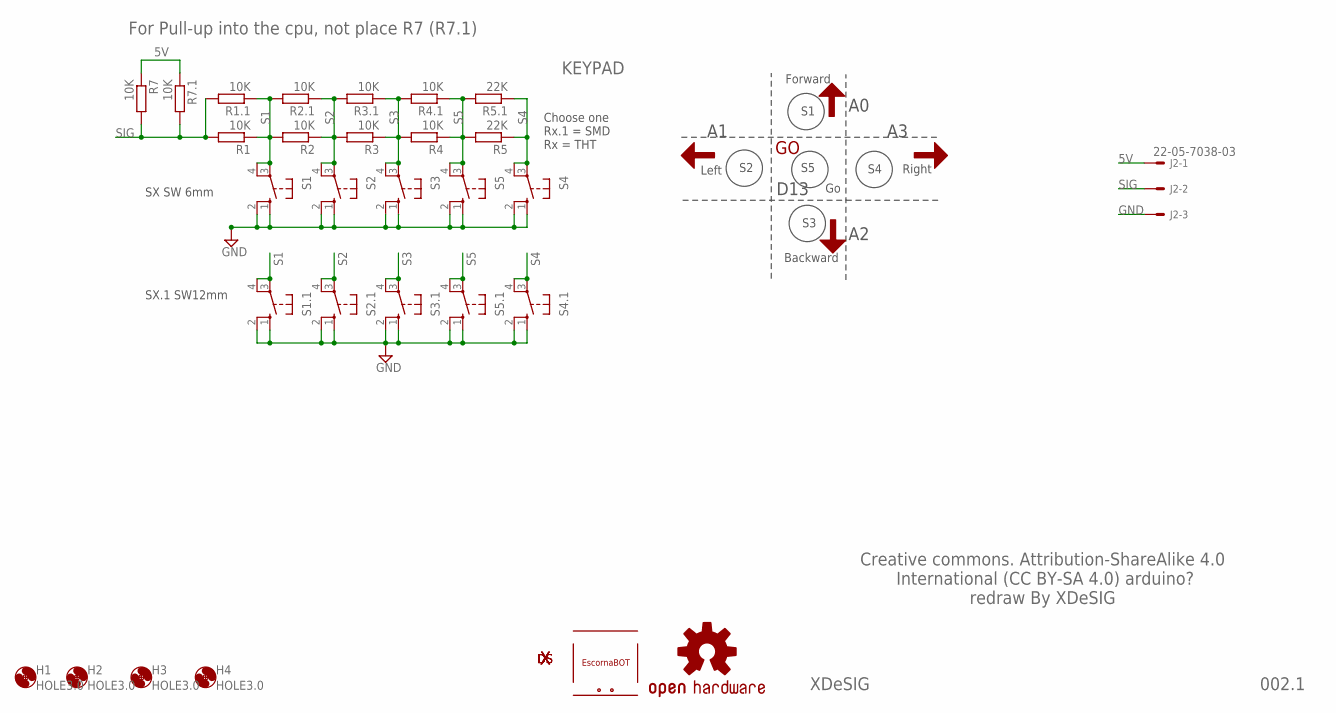
[picture p108: schematic E_KEYPAD__2_1.sch]

Parts:
H1, H2, H3, H4: HOLE3.0; 3,0
J2: 22-05-7038-03; 7395-03
LOGO2: OSHW-LOGOS; OSHW-LOGO-S
R1, R2, R3, R4, R7: 10K; 0204/7
R1.1, R2.1, R3.1, R4.1, R7.1: 10K; R0603
R5: 22K; 0204/7
R5.1: 22K; R0603
S1, S2, S3, S4, S5: 10-XX; B3F-10XX
S1.1, S2.1, S3.1, S4.1, S5.1: 40-XX; B3F-40XX
U$1: ESCORNABOT; ESCORNA_PEQUE
U$3, U$4, U$6, U$11: FRECHA
U$5: GO; VALE
U$7: XDESIG21; XDESIG
U$8: XDESIG; XDESIG_CU_2

Connections:
5V: J2.1, R7.1, R7.1.1
GND: J2.3, S1.1 (S), S1.2 (S1), S1.1.1 (S), S1.1.2 (S1), S2.1 (S), S2.2 (S1), S2.1.1 (S), S2.1.2 (S1), S3.1 (S), S3.2 (S1), S3.1.1 (S), S3.1.2 (S1), S4.1 (S), S4.2 (S1), S4.1.1 (S), S4.1.2 (S1), S5.1 (S), S5.2 (S1), S5.1.1 (S), S5.1.2 (S1)
S1: R1.1, R1.1.1, R2.2, R2.1.2, S1.3, S1.4 (P1), S1.1.3, S1.1.4 (P1)
S2: R2.1, R2.1.1, R3.2, R3.1.2, S2.3, S2.4 (P1), S2.1.3, S2.1.4 (P1)
S3: R3.1, R3.1.1, R4.2, R4.1.2, S3.3, S3.4 (P1), S3.1.3, S3.1.4 (P1)
S4: R5.1, R5.1.1, S4.3, S4.4 (P1), S4.1.3, S4.1.4 (P1)
S5: R4.1, R4.1.1, R5.2, R5.1.2, S5.3, S5.4 (P1), S5.1.3, S5.1.4 (P1)
SIG: J2.2, R1.2, R1.1.2, R7.2, R7.1.2

Notes on the sheet:
For Pull-up into the cpu, not place R7 (R7.1)
002.1
Creative commons. Attribution-ShareAlike 4.0 International (CC BY-SA 4.0) arduino? redraw By XDeSIG
XDeSIG
KEYPAD
Choose one Rx.1 = SMD Rx = THT
SX.1 SW12mm
SX SW 6mm
Forward
Left
Right
Backward
D13

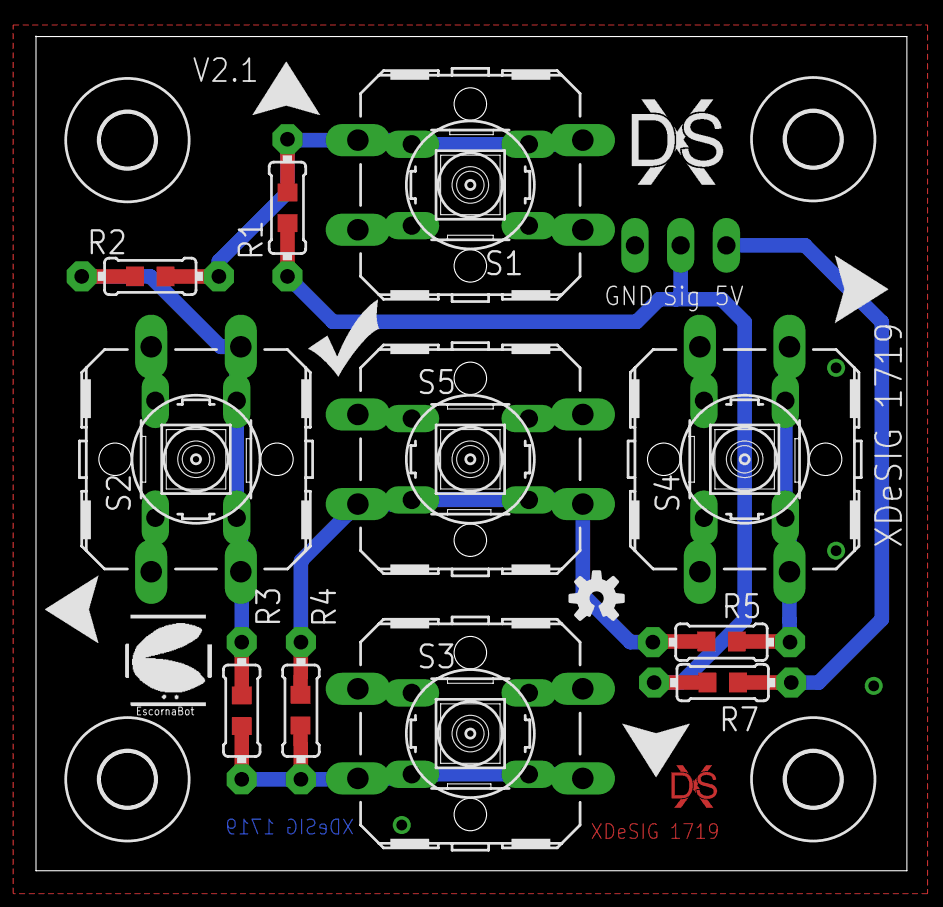
[picture p109: board E_KEYPAD__2_1.brd from above]

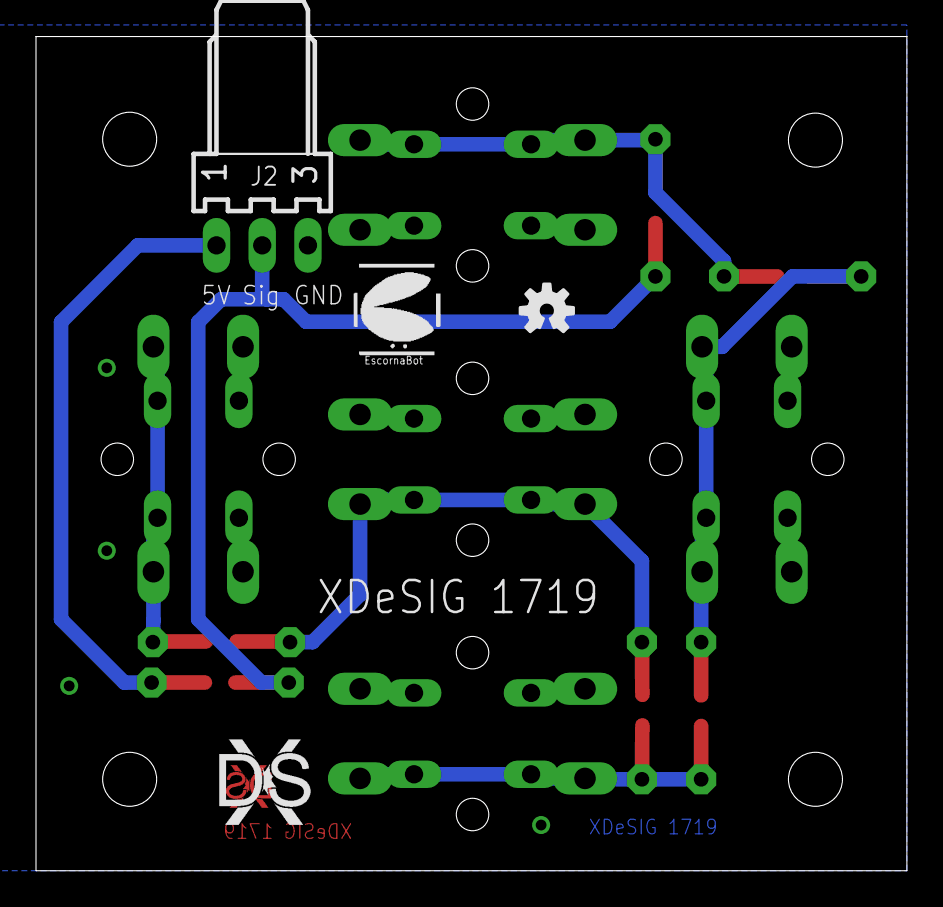
[picture p110: board E_KEYPAD__2_1.brd from below]

Board: 2 copper layers, 48.4 x 46.4 mm, 39 parts (4 on the bottom side), 8 nets.

Other parts of the board:
LOGO1: OSHW-LOGOS; OSHW-LOGO-S
U$2: ESCORNABOT; ESCORNA_PEQUE
U$9: XDESIG21; XDESIG
