ionhs/Escornabot-2.12/Recopilación/electronics-master (2)/electronics-master/EscornaCPU/2.x/2.10/Escorna_CPU_2_10.brd

## EAGLE design Recopilación/electronics-master (2)/electronics-master/EscornaCPU/2.x/2.10/Escorna_CPU_2_10.brd (2018-10-16)

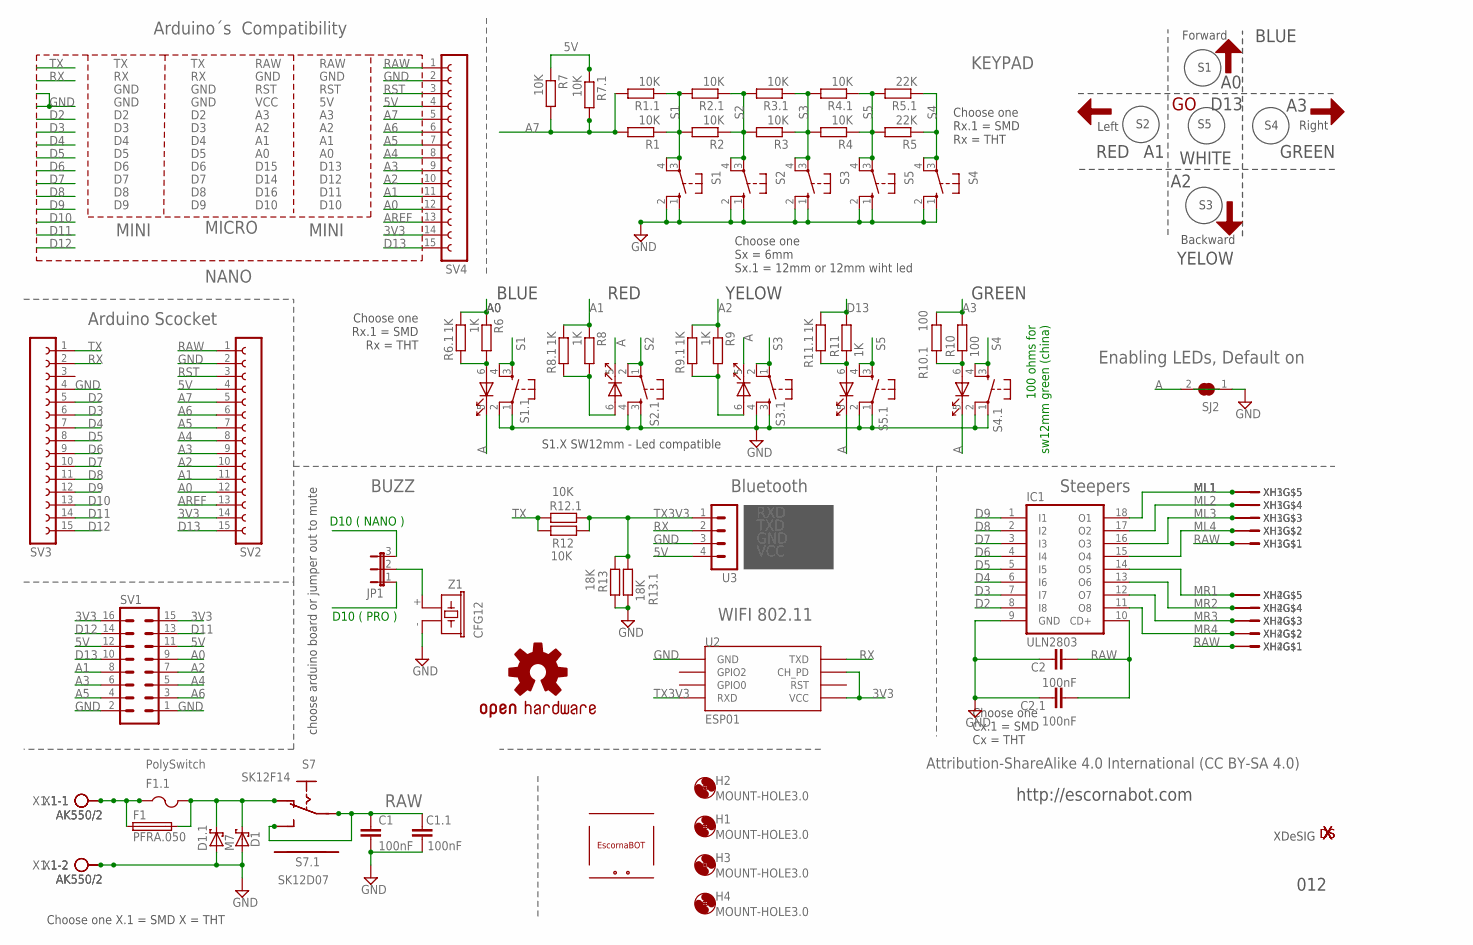
[picture p111: schematic Escorna_CPU_2_10.sch]

Parts:
C1, C2: 100nF; C025-025X050
C1.1, C2.1: 100nF; C1206
D1: 1N5817; DO41-10
D1.1: M7; SMA
ESC: ESCORNABOT; ESCORNA_PEQUE
F1: PFRA.050; TE5
F1.1: PolySwitch; R1206
H1, H2, H3, H4: MOUNT-HOLE3.0; 3,0
IC1: ULN2803; DIL18
JP1: JUMPER_JP2E; JUMPER_JP2
LOGO2: OSHW-LOGOS; OSHW-LOGO-S
R1, R2, R3, R4, R7, R12: 10K; 0204/7
R1.1, R2.1, R3.1, R4.1, R7.1, R12.1: 10K; R0603
R5: 22K; 0204/7
R5.1: 22K; R0603
R6, R8, R9, R11: 1K; 0204/7
R6.1, R8.1, R9.1, R11.1: 1K; R0603
R10: 100; 0204/7
R10.1: 100; R0603
R13: 18K; 0204/7
R13.1: 18K; R0603
S1, S2, S3, S4, S5: 10-XX; B3F-10XX
S1.1, S2.1, S3.1, S4.1, S5.1: B3F-9XXX
S7: SK12F14; ESCORNA_SK-12F14-G
S7.1: SK12D07; ESCORNA_SK-12D07
SJ2: SJ
SV1: MA08-2
SV2, SV3, SV4: CON-LSTA_FE15-1; CON-LSTA_FE15
U2: ESP01
U3: MA04-1
U$1, U$3, U$6, U$11: FRECHA
U$2: GO; VALE
U$13: XDESIG_XDESIG21; XDESIG_XDESIG
X1, X1.1: AK550/2
XDS1: XDESIG; XDESIG_CU_2
XH1, XH2, XH3, XH4: B5B-XH-A
Z1: CFG12; F/CM12P

Connections:
3V3: SV1.15, SV1.16, SV2.14, SV4.14, U2.CH_PD, U2.VCC
5V: R7.1, R7.1.1, SV1.11, SV1.12, SV2.4, SV4.4, U3.4
A: S1.1.5 (K), S2.1.5 (K), S3.1.5 (K), S4.1.5 (K), S5.1.5 (K), SJ2.2
A0: JP1.1, R6.1, R6.1.1, SV1.9, SV2.12, SV4.12
A1: R8.1, R8.1.1, SV1.8, SV2.11, SV4.11
A2: R9.1, R9.1.1, SV1.7, SV2.10, SV4.10
A3: R10.2, R10.1.1, SV1.6, SV2.9, SV4.9
A4: SV1.5, SV2.8, SV4.8
A5: SV1.4, SV2.7, SV4.7
A6: SV1.3, SV2.6, SV4.6
A7: R1.2, R1.1.2, R7.2, R7.1.2, SV2.5, SV4.5
AREF: SV2.13, SV4.13
D2: IC1.8 (I8), SV3.5
D3: IC1.7 (I7), SV3.6
D4: IC1.6 (I6), SV3.7
D5: IC1.5 (I5), SV3.8
D6: IC1.4 (I4), SV3.9
D7: IC1.3 (I3), SV3.10
D8: IC1.2 (I2), SV3.11
D9: IC1.1 (I1), SV3.12
D10: JP1.3, SV3.13
D11: SV1.13, SV3.14
D12: SV1.14, SV3.15
D13: R11.2, R11.1.1, SV1.10, SV2.15, SV4.15
GND: C1.2, C1.1.1, C2.1, C2.1.1, D1.A, D1.1.A, IC1.9 (GND), R13.2, R13.1.1, S1.1 (S), S1.2 (S1), S1.1.1, S1.1.2 (P1), S2.1 (S), S2.2 (S1), S2.1.3 (S), S2.1.4 (S1), S3.1 (S), S3.2 (S1), S3.1.3 (S), S3.1.4 (S1), S4.1 (S), S4.2 (S1), S4.1.1, S4.1.2 (P1), S5.1 (S), S5.2 (S1), S5.1.1, S5.1.2 (P1), SJ2.1, SV1.1, SV1.2, SV2.2, SV3.4, SV4.2, U2.GND, U3.3, X1.2, X1.1.2, Z1.- (2)
ML1: IC1.18 (O1), XH1.P$5, XH3.P$5
ML2: IC1.17 (O2), XH1.P$4, XH3.P$4
ML3: IC1.16 (O3), XH1.P$3, XH3.P$3
ML4: IC1.15 (O4), XH1.P$2, XH3.P$2
MR1: IC1.14 (O5), XH2.P$5, XH4.P$5
MR2: IC1.13 (O6), XH2.P$4, XH4.P$4
MR3: IC1.12 (O7), XH2.P$3, XH4.P$3
MR4: IC1.11 (O8), XH2.P$2, XH4.P$2
unnamed: JP1.2, Z1.+ (1)
unnamed: D1.C, D1.1.C, F1.2, F1.1.2, S7.P$2 (O), S7.1.P$2 (O)
unnamed: R8.2, R8.1.2, S2.1.6 (A)
unnamed: R6.2, R6.1.2, S1.1.6 (A)
unnamed: R9.2, R9.1.2, S3.1.6 (A)
unnamed: R10.1, R10.1.2, S4.1.6 (A)
unnamed: S7.P$4, S7.1.P$4
unnamed: S7.P$5, S7.1.P$5
unnamed: F1.1, F1.1.1, X1.1, X1.1.1
unnamed: R11.1, R11.1.2, S5.1.6 (A)
RAW: C1.1, C1.1.2, C2.2, C2.1.2, IC1.10 (CD+), S7.P$1, S7.P$3 (S), S7.1.P$1, S7.1.P$3 (S), SV2.1, SV4.1, XH1.P$1, XH2.P$1, XH3.P$1, XH4.P$1
RST: SV2.3, SV4.3
RX: SV3.2, U2.TX (TXD), U3.2
S1: R1.1, R1.1.1, R2.2, R2.1.2, S1.3, S1.4 (P1), S1.1.3 (S), S1.1.4 (S1)
S2: R2.1, R2.1.1, R3.2, R3.1.2, S2.3, S2.4 (P1), S2.1.1, S2.1.2 (P1)
S3: R3.1, R3.1.1, R4.2, R4.1.2, S3.3, S3.4 (P1), S3.1.1, S3.1.2 (P1)
S4: R5.1, R5.1.1, S4.3, S4.4 (P1), S4.1.3 (S), S4.1.4 (S1)
S5: R4.1, R4.1.1, R5.2, R5.1.2, S5.3, S5.4 (P1), S5.1.3 (S), S5.1.4 (S1)
TX: R12.1, R12.1.1, SV3.1
TX3V3: R12.2, R12.1.2, R13.1, R13.1.2, U2.RX (RXD), U3.1

Notes on the sheet:
Arduino Scocket
Steepers
KEYPAD
BUZZ
Bluetooth
RXD
TXD
GND
VCC
D10 ( NANO )
D10 ( PRO )
NANO
Arduino´s Compatibility
MINI
MICRO
RAW
RST
D13
D15
D12
D14
D11
D16
D10
Attribution-ShareAlike 4.0 International (CC BY-SA 4.0)
Forward
Left
Right
Backward
WIFI 802.11
Choose one Rx.1 = SMD Rx = THT
Choose one X.1 = SMD X = THT
XDeSIG
http://escornabot.com
Choose one Cx.1 = SMD Cx = THT
S1.X SW12mm - Led compatible
012
Enabling LEDs, Default on
choose arduino board or jumper out to mute
100 ohms for sw12mm green (china)
BLUE
RED
YELOW
WHITE
GREEN
Choose one Sx = 6mm Sx.1 = 12mm or 12mm wiht led

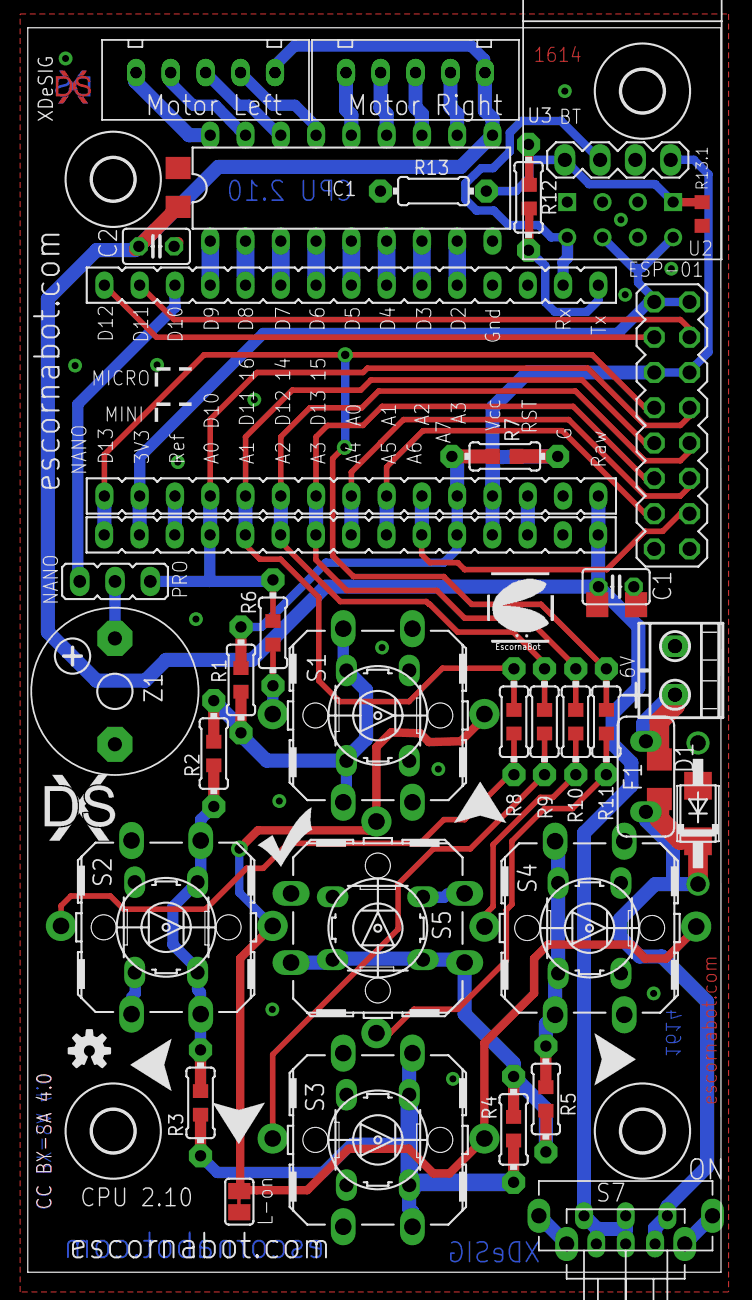
[picture p112: board Escorna_CPU_2_10.brd from above]

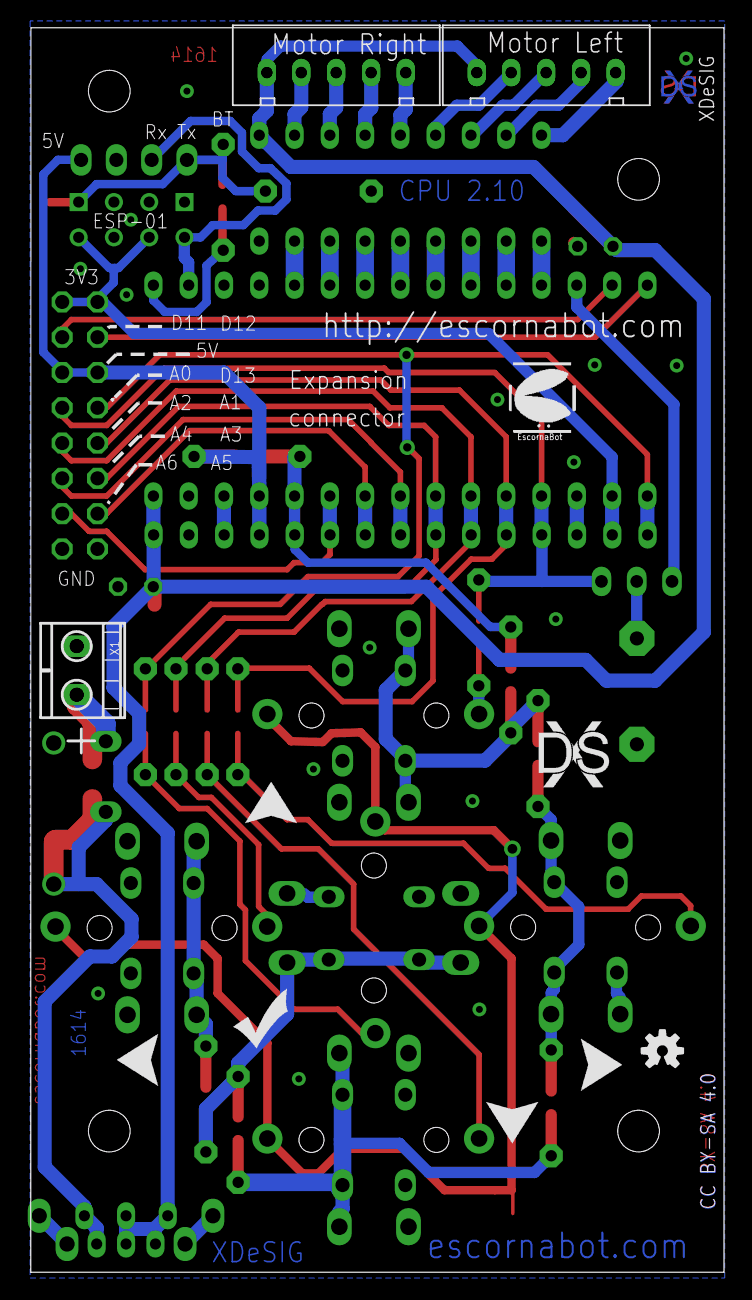
[picture p113: board Escorna_CPU_2_10.brd from below]

Board: 2 copper layers, 49.9 x 89.6 mm, 84 parts (12 on the bottom side), 53 nets.

Other parts of the board:
LOGO1: OSHW-LOGOS; OSHW-LOGO-S
U$4, U$7, U$8, U$9: FRECHA
U$5: ESCORNABOT; ESCORNA_PEQUE
U$10: GO; VALE
U$12: XDESIG_XDESIG21; XDESIG_XDESIG
XDS: XDESIG; XDESIG_CU_2
