ionhs/Escornabot-2.12/Recopilación/electronics-master (2)/electronics-master/Keypad/E_KEYPAD_2.0D/Escorna_Shield_botoneira_2_0D.brd

## EAGLE design Recopilación/electronics-master (2)/electronics-master/Keypad/E_KEYPAD_2.0D/Escorna_Shield_botoneira_2_0D.brd (2018-10-16)

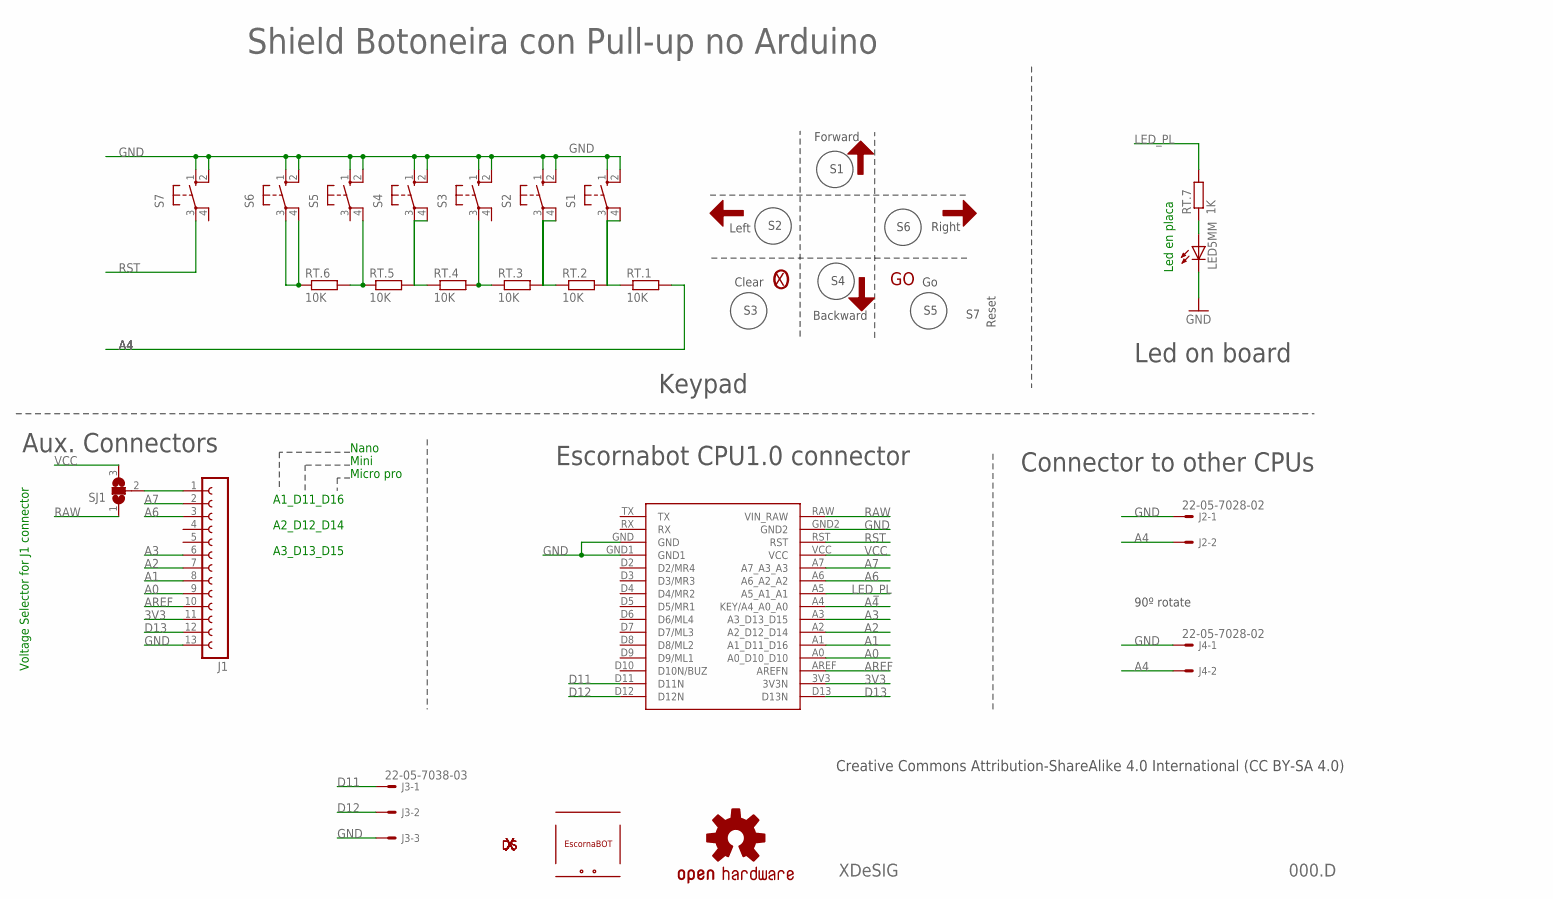
[picture p114: schematic Escorna_Shield_botoneira_2_0D.sch]

Parts:
ESSH1: OUTL_ESCORNASHILED; OUTL_ESCORNASHIELD
J1: FE13-1; FE13
J2, J4: 22-05-7028-02; 7395-02
J3: 22-05-7038-03; 7395-03
LED5MM: LED5MM
LOGO2: OSHW-LOGOS; OSHW-LOGO-S
RT.1, RT.2, RT.3, RT.4, RT.5, RT.6: 10K; 0204/7
RT.7: 1K; 0204/7
S1, S2, S3, S4, S5, S6: B3F-40XX; B3F40XX_NH
S7: 10-XX; B3F-10XX
SJ1: SOLDERJUMPER_2WAY; SJ_2
U$1: ESCORNABOT; ESCORNA_PEQUE
U$3: XDESIG21; XDESIG
U$4, U$5, U$6, U$7: FRECHA
U$8: GO; VALE
U$9: CANCELA; ASPA
U$10: XDESIG; XDESIG_CU_2

Connections:
3V3: ESSH1.3V3 (3V3N), J1.11
A0: ESSH1.A0 (A0_D10_D10), J1.9
A1: ESSH1.A1 (A1_D11_D16), J1.8
A2: ESSH1.A2 (A2_D12_D14), J1.7
A3: ESSH1.A3 (A3_D13_D15), J1.6
A4: ESSH1.A4 (KEY/A4_A0_A0), J2.2, J4.2, RT.1.2
A6: ESSH1.A6 (A6_A2_A2), J1.3
A7: ESSH1.A7 (A7_A3_A3), J1.2
AREF: ESSH1.AREF (AREFN), J1.10
D11: ESSH1.D11 (D11N), J3.1
D12: ESSH1.D12 (D12N), J3.2
D13: ESSH1.D13 (D13N), J1.12
GND: ESSH1.GND, ESSH1.GND1, ESSH1.GND2, J1.13, J2.1, J3.3, J4.1, LED5MM.K (C), S1.1 (S), S1.2 (S1), S2.1 (S), S2.2 (S1), S3.1 (S), S3.2 (S1), S4.1 (S), S4.2 (S1), S5.1 (S), S5.2 (S1), S6.1 (S), S6.2 (S1), S7.1 (S), S7.2 (S1)
LED_PL: ESSH1.A5 (A5_A1_A1), RT.7.2
unnamed: LED5MM.A, RT.7.1
unnamed: J1.1, SJ1.2
unnamed: RT.2.2, S1.4 (P1)
unnamed: RT.1.1, S1.3
unnamed: RT.5.2, S4.4 (P1)
unnamed: RT.6.1, S6.3, S6.4 (P1)
unnamed: RT.4.1, S4.3
unnamed: RT.3.1, RT.4.2, S3.3
unnamed: RT.2.1, S2.3
unnamed: RT.3.2, S2.4 (P1)
unnamed: RT.5.1, RT.6.2, S5.4 (P1)
RAW: ESSH1.RAW (VIN_RAW), SJ1.1
RST: ESSH1.RST, S7.3
VCC: ESSH1.VCC, SJ1.3

Notes on the sheet:
Shield Botoneira con Pull-up no Arduino
000.D
XDeSIG
Forward
Left
Right
Backward
Clear
Led en placa
A1_D11_D16
A2_D12_D14
A3_D13_D15
Voltage Selector for J1 connector
Reset
Led on board
Keypad
Escornabot CPU1.0 connector
Connector to other CPUs
Aux. Connectors
Nano
Mini
Micro pro
90º rotate
Creative Commons Attribution-ShareAlike 4.0 International (CC BY-SA 4.0)

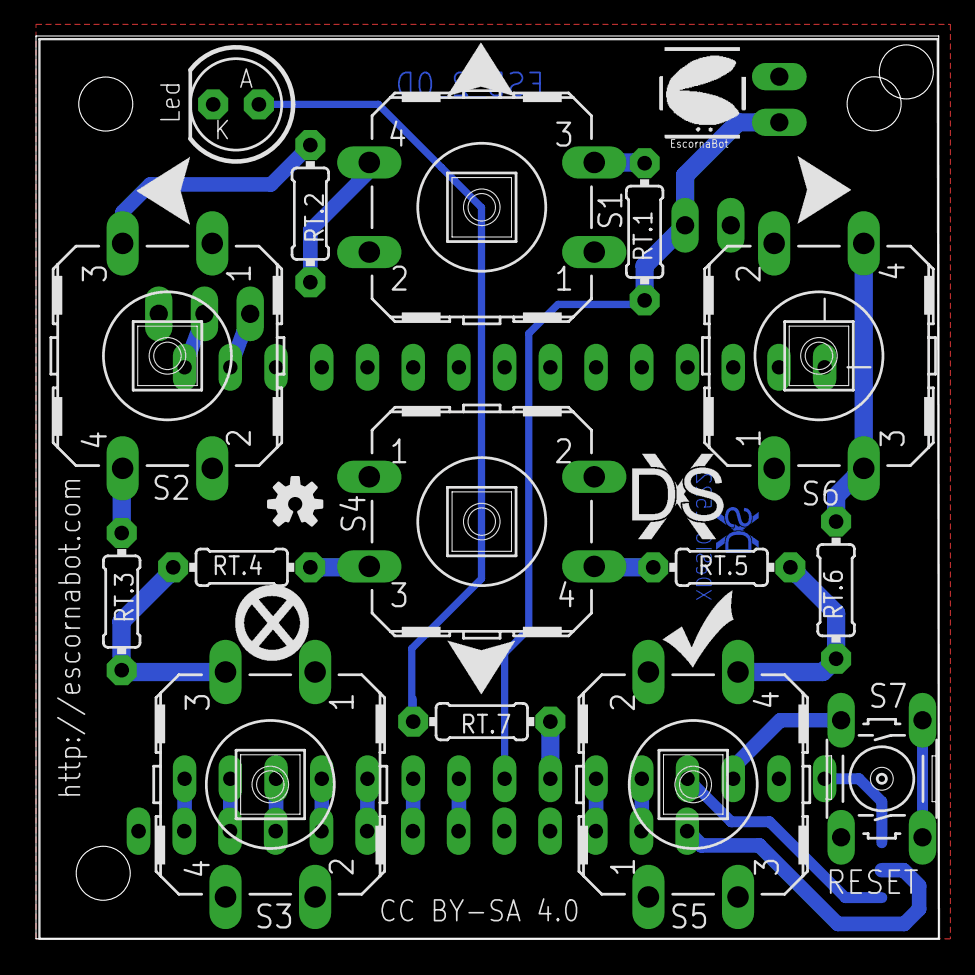
[picture p115: board Escorna_Shield_botoneira_2_0D.brd from above]

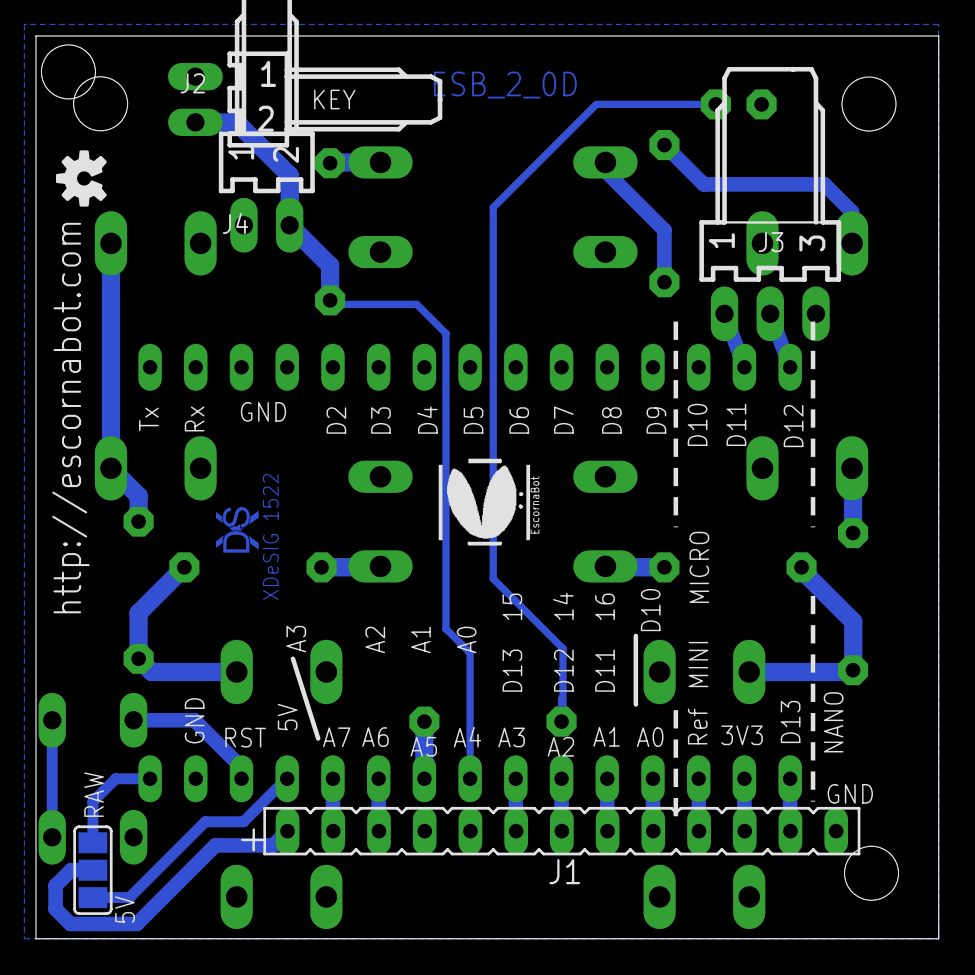
[picture p116: board Escorna_Shield_botoneira_2_0D.brd from below]

Board: 2 copper layers, 50.2 x 50.2 mm, 33 parts (8 on the bottom side), 28 nets.

Other parts of the board:
LOGO1: OSHW-LOGOS; OSHW-LOGO-S
U$2: ESCORNABOT; ESCORNA_PEQUE
