ionhs/Escornabot-2.12/Recopilación/electronics-master (2)/electronics-master/ArduinoShield/BotMotShielArdu.brd

## EAGLE design Recopilación/electronics-master (2)/electronics-master/ArduinoShield/BotMotShielArdu.brd (2018-10-16)

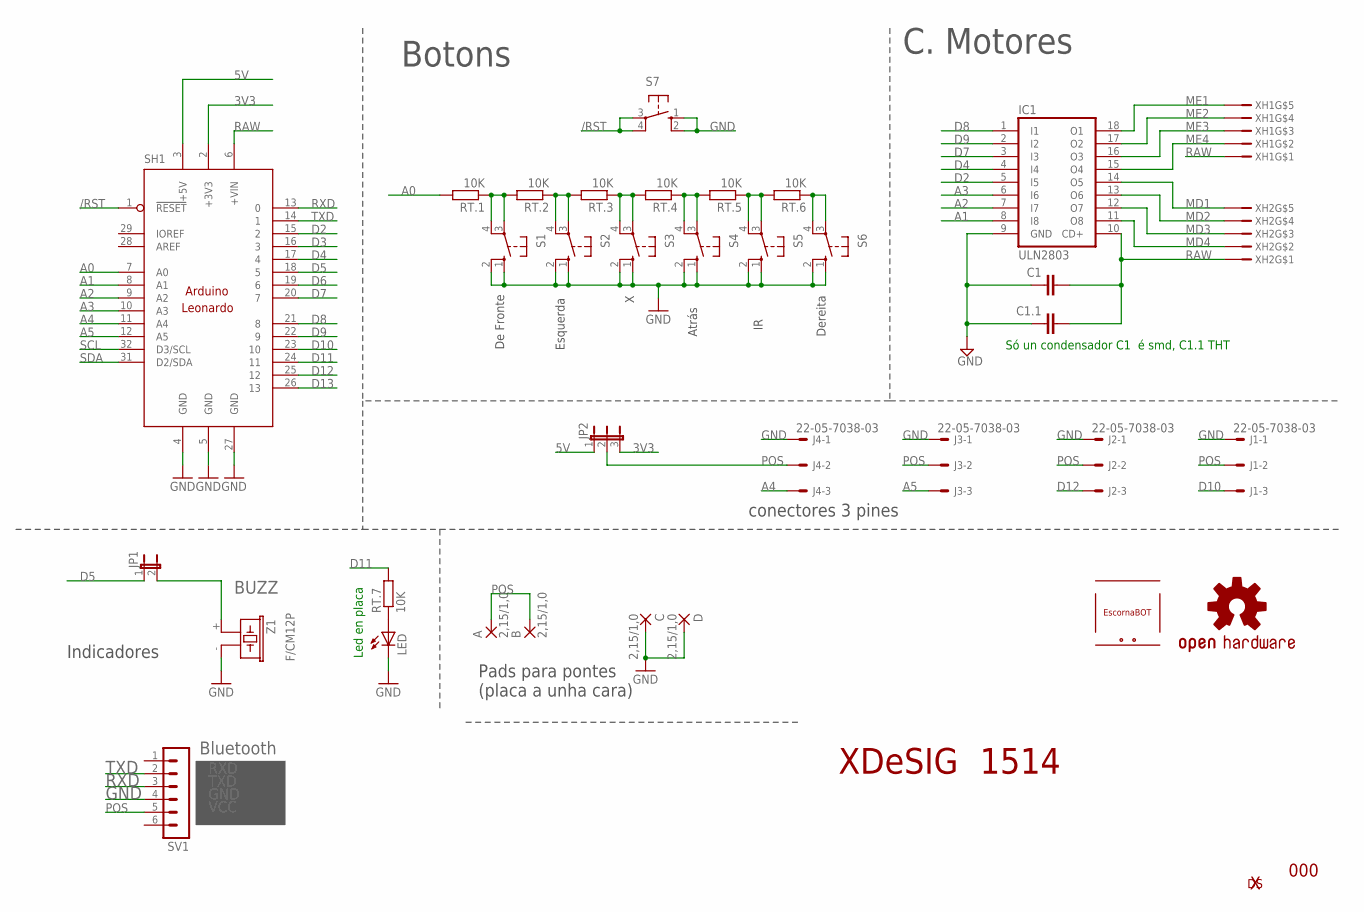
[picture p117: schematic BotMotShielArdu.sch]

Parts:
A: 2,15/1,0
B: 2,15/1,0
C: 2,15/1,0
C1: C-EUC1206; C1206
C1.1: C-EU025-024X044; C025-024X044
D: 2,15/1,0
IC1: ULN2803; DIL18
J1, J2, J3, J4: 22-05-7038-03; 7395-03
JP1: JP1E; JP1
JP2: JP2E; JP2
LED: LED5MM
LOGO4: OSHW-LOGOS; OSHW-LOGO-S
RT.1, RT.2, RT.3, RT.4, RT.5, RT.6, RT.7: 10K; 0204/7
S1, S2, S3, S4, S5, S6: B3F-40XX; B3F40XX_NH
S7: 10-XX; B3F-10XX
SH1: ARDUINO_LEONARDO; LEONARDO
SV1: MA06-1
U$1: ESCORNABOT; ESCORNA_PEQUE
U$3: XDESIG1; XDESIG_CU
XH1, XH2: B5B-XH-A
Z1: F/CM12P

Connections:
3V3: JP2.3, SH1.2 (+3V3)
5V: JP2.1, SH1.3 (+5V)
/RST: S7.3, S7.4 (P1), SH1.1 (!RESET)
A0: RT.1.2, SH1.7 (A0)
A1: IC1.8 (I8), SH1.8 (A1)
A2: IC1.7 (I7), SH1.9 (A2)
A3: IC1.6 (I6), SH1.10 (A3)
A4: J4.3, SH1.11 (A4)
A5: J3.3, SH1.12 (A5)
D2: IC1.5 (I5), SH1.15 (2)
D3: SH1.16 (3)
D4: IC1.4 (I4), SH1.17 (4)
D5: JP1.1, SH1.18 (5)
D6: SH1.19 (6)
D7: IC1.3 (I3), SH1.20 (7)
D8: IC1.1 (I1), SH1.21 (8)
D9: IC1.2 (I2), SH1.22 (9)
D10: J1.3, SH1.23 (10)
D11: RT.7.2, SH1.24 (11)
D12: J2.3, SH1.25 (12)
D13: SH1.26 (13)
GND: C.1, C1.1, C1.1.1, D.1, IC1.9 (GND), J1.1, J2.1, J3.1, J4.1, LED.K (C), S1.1 (S), S1.2 (S1), S2.1 (S), S2.2 (S1), S3.1 (S), S3.2 (S1), S4.1 (S), S4.2 (S1), S5.1 (S), S5.2 (S1), S6.1 (S), S6.2 (S1), S7.1 (S), S7.2 (S1), SH1.4 (GND), SH1.5 (GND), SH1.27 (GND), SV1.4, Z1.- (2)
MD1: IC1.14 (O5), XH2.P$5
MD2: IC1.13 (O6), XH2.P$4
MD3: IC1.12 (O7), XH2.P$3
MD4: IC1.11 (O8), XH2.P$2
ME1: IC1.18 (O1), XH1.P$5
ME2: IC1.17 (O2), XH1.P$4
ME3: IC1.16 (O3), XH1.P$3
ME4: IC1.15 (O4), XH1.P$2
unnamed: LED.A, RT.7.1
unnamed: RT.6.1, S6.3, S6.4 (P1)
unnamed: RT.1.1, RT.2.2, S1.3, S1.4 (P1)
unnamed: JP1.2, Z1.+ (1)
unnamed: RT.5.1, RT.6.2, S5.3, S5.4 (P1)
unnamed: RT.4.1, RT.5.2, S4.3, S4.4 (P1)
unnamed: RT.3.1, RT.4.2, S3.3, S3.4 (P1)
unnamed: RT.2.1, RT.3.2, S2.3, S2.4 (P1)
POS: A.1, B.1, J1.2, J2.2, J3.2, J4.2, JP2.2, SV1.5
RAW: C1.2, C1.1.2, IC1.10 (CD+), SH1.6 (+VIN), XH1.P$1, XH2.P$1
RXD: SH1.13 (0), SV1.3
SCL: SH1.32 (D3/SCL)
SDA: SH1.31 (D2/SDA)
TXD: SH1.14 (1), SV1.2

Notes on the sheet:
Só un condensador C1 é smd, C1.1 THT
De Fronte
Esquerda
Dereita
Atrás
Led en placa
BUZZ
Bluetooth
RXD
TXD
GND
VCC
Botons
C. Motores
conectores 3 pines
Indicadores
Pads para pontes (placa a unha cara)
XDeSIG
1514
000

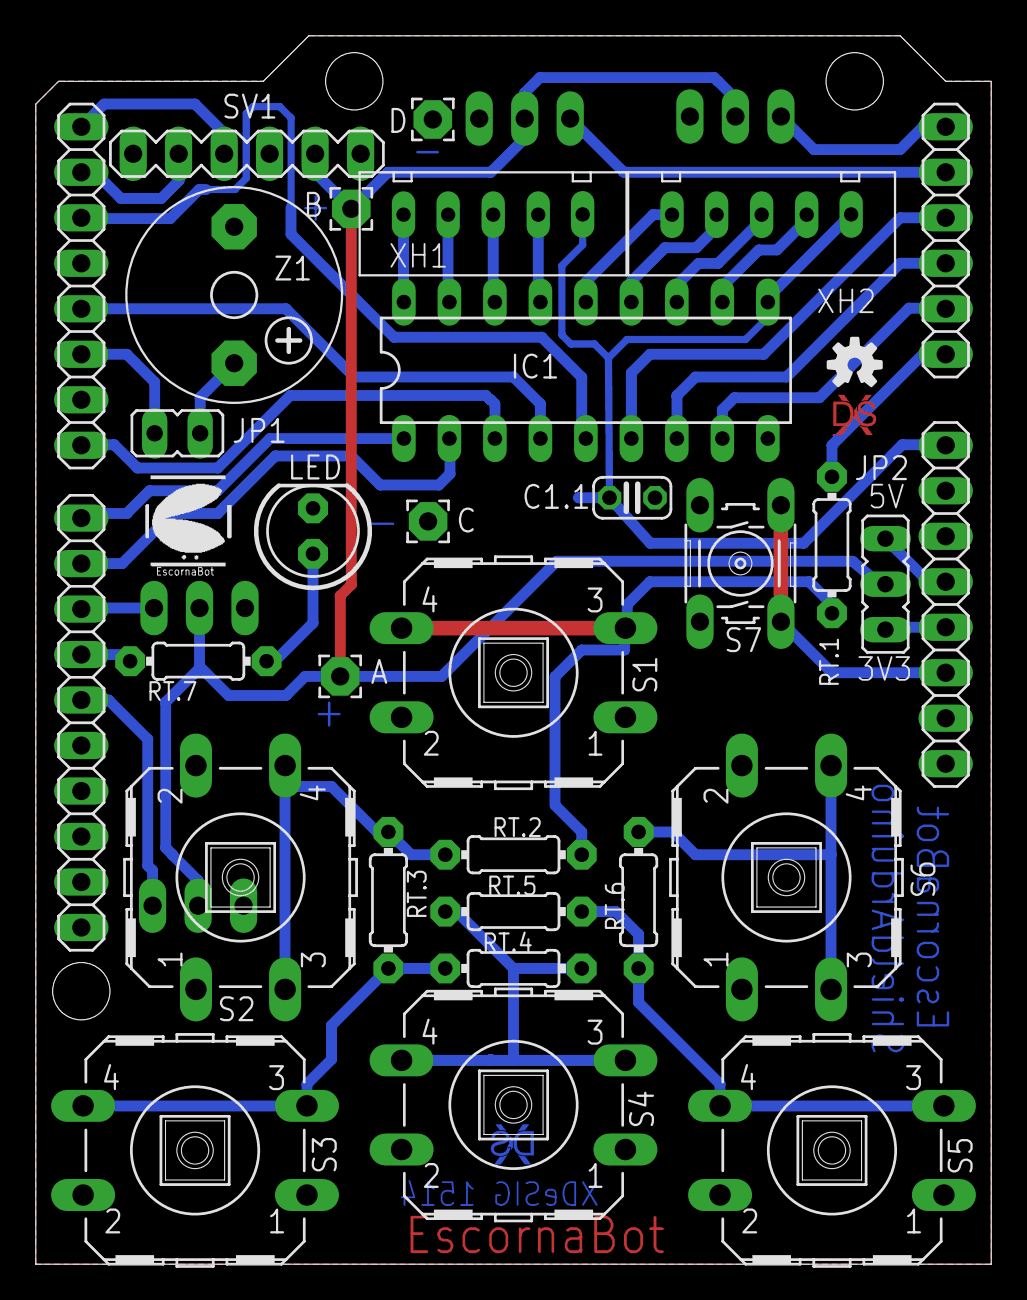
[picture p118: board BotMotShielArdu.brd from above]

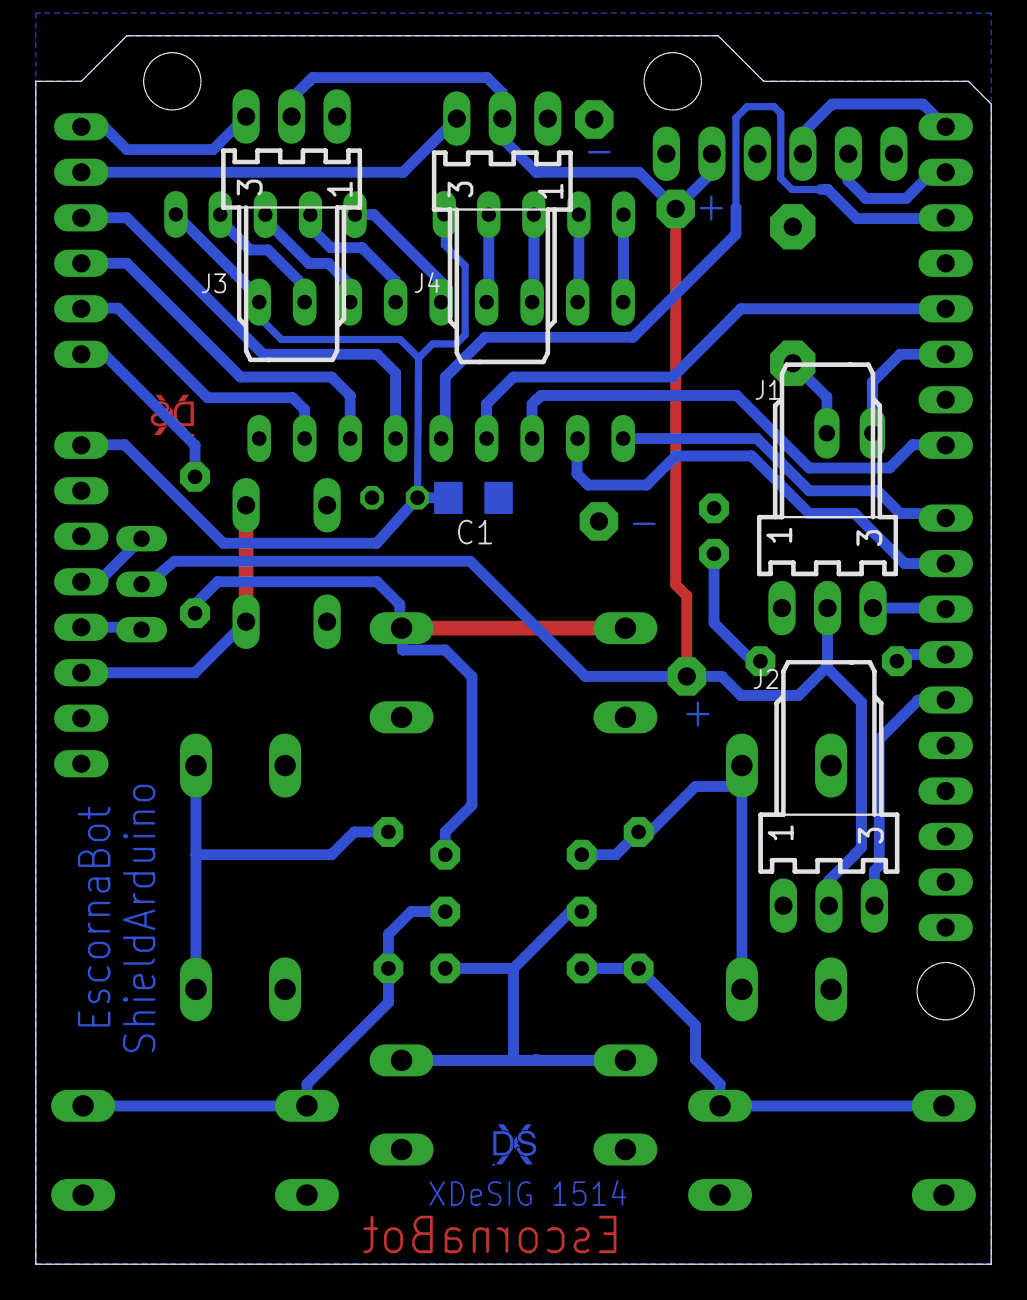
[picture p119: board BotMotShielArdu.brd from below]

Board: 2 copper layers, 53.3 x 68.6 mm, 37 parts (6 on the bottom side), 39 nets.

Other parts of the board:
U$2: XDESIG1; XDESIG_CU
