ionhs/Escornabot-2.12/Recopilación/electronics-master (2)/electronics-master/Cervus/cervus_2_0.brd

## EAGLE design Recopilación/electronics-master (2)/electronics-master/Cervus/cervus_2_0.brd (2018-10-16)

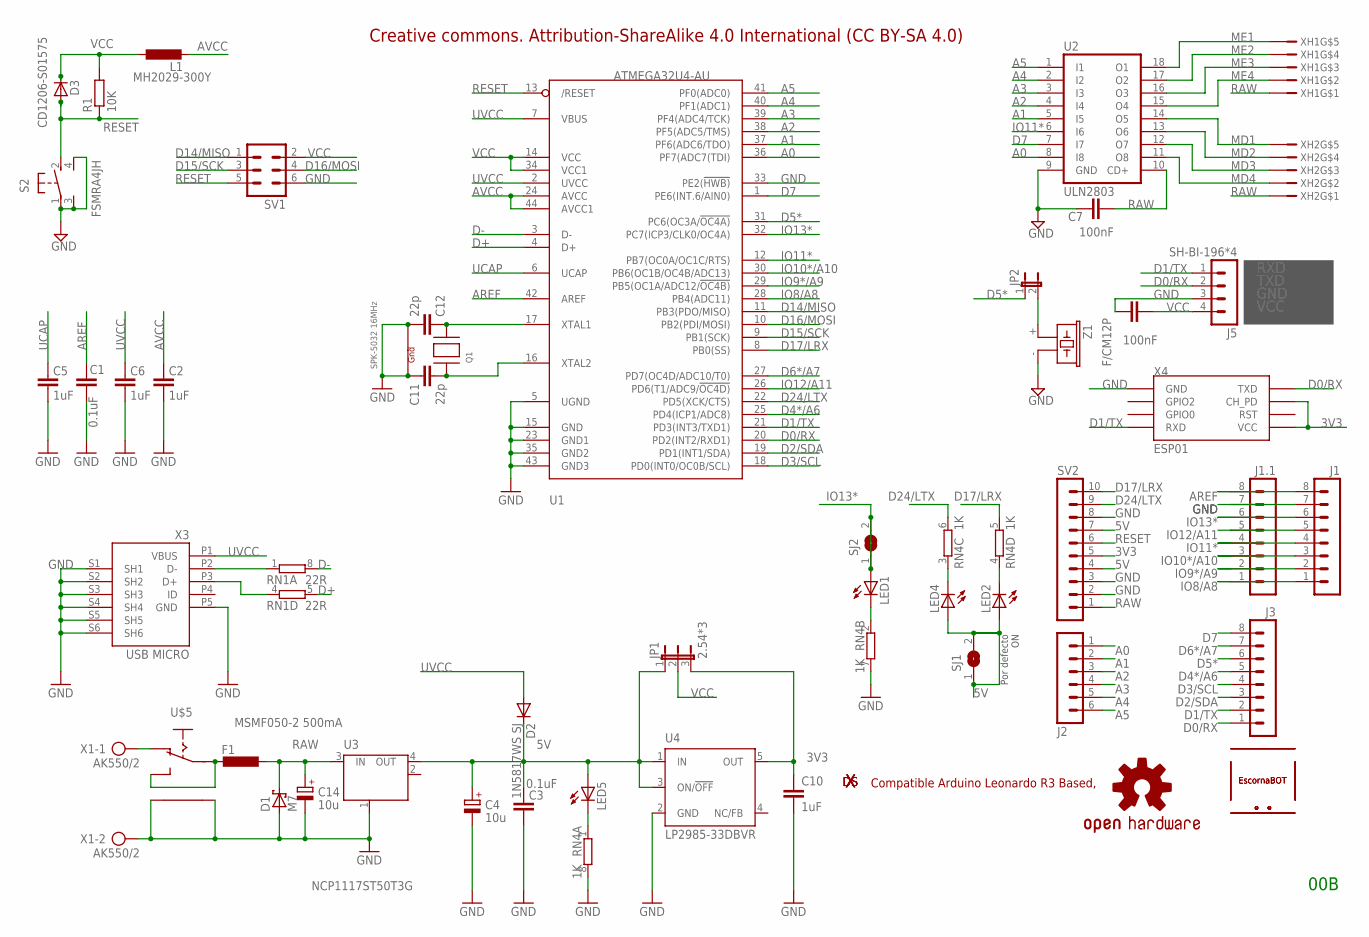
[picture p120: schematic cervus_2_0.sch]

Parts:
C1, C3: 0.1uF; 0603-CAP
C2, C5, C6, C10: 1uF; 0603-CAP
C4, C14: 10u; SMC_B
C7, C8: 100nF; C0603K
C11, C12: 22p; C0603-ROUND
D1: M7; SMA
D2: 1N5817WS SJ; SOD-323
D3: CD1206-S01575; MINIMELF
F1: MSMF050-2 500mA; L1812
J1, J1.1, J3: MA08-1
J2: MA06-1
J5: SH-BI-196*4; MA04-1
JP1: 2.54*3; JP2
JP2: JP1E; JP1
L1: MH2029-300Y; R0805
LED1, LED2, LED4, LED5: LEDCHIPLED_0603; CHIPLED_0603
LOGO1: OSHW-LOGOS; OSHW-LOGO-S
Q1: SPK-5032 16MHz; NX3225
R1: 10K; R0603
RN1: 22R; CAY16
RN4: 1K; CAY16
S2: FSMRA4JH; B3F-31XX
SJ1, SJ2: SJ
SV1: MA03-2
SV2: MA10-1
U1: ATMEGA32U4-AU; TQFP44
U2: ULN2803; DIL18
U3: NCP1117ST50T3G; SOT223
U4: LP2985-33DBVR; SOT23-DBV
U$1, U$2: XDESIG; XDESIG_CU_2
U$3, U$4: ESCORNABOT; ESCORNA_PEQUE
U$5: ESCORNA_SK12F14D; ESCORNA_SK-12D07
X1: AK550/2
X3: USB MICRO; CON2_USB_MICRO_B_AT
X4: ESP01
XH1, XH2: XH2.54-5P; B5B-XH-A
Z1: F/CM12P

Connections:
3V3: C10.1, JP1.3, SV2.5, U4.5 (OUT), X4.CH_PD, X4.VCC
5V: C3.2, C4.+, D2.1 (C), JP1.1, LED2.A, LED4.A, LED5.A, SJ1.1, SJ1.2, SV2.4, SV2.7, U3.4 (OUT), U4.1 (IN), U4.3 (ON/!OFF)
A0: J2.1, U1.36 (PF7(ADC7(TDI)), U2.8 (I8)
A1: J2.2, U1.37 (PF6(ADC6/TDO)), U2.5 (I5)
A2: J2.3, U1.38 (PF5(ADC5/TMS)), U2.4 (I4)
A3: J2.4, U1.39 (PF4(ADC4/TCK)), U2.3 (I3)
A4: J2.5, U1.40 (PF1(ADC1)), U2.2 (I2)
A5: J2.6, U1.41 (PF0(ADC0)), U2.1 (I1)
AREF: C1.2, J1.8, J1.1.8, U1.42 (AREF)
AVCC: C2.2, L1.2, U1.24 (AVCC), U1.44 (AVCC1)
D0/RX: J3.1, J5.2, U1.20 (PD2(INT2/RXD1)), X4.TX (TXD)
D1/TX: J3.2, J5.1, U1.21 (PD3(INT3/TXD1)), X4.RX (RXD)
D2/SDA: J3.3, U1.19 (PD1(INT1/SDA))
D3/SCL: J3.4, U1.18 (PD0(INT0/OC0B/SCL))
D4*/A6: J3.5, U1.25 (PD4(ICP1/ADC8))
D5*: J3.6, JP2.1, U1.31 (PC6(OC3A/!OC4A))
D6*/A7: J3.7, U1.27 (PD7(OC4D/ADC10/T0))
D7: J3.8, U1.1 (PE6(INT.6/AIN0)), U2.7 (I7)
D14/MISO: SV1.1, U1.11 (PB3(PDO/MISO))
D15/SCK: SV1.3, U1.9 (PB1(SCK))
D16/MOSI: SV1.4, U1.10 (PB2(PDI/MOSI))
D17/LRX: RN4.5 (2), SV2.10, U1.8 (PB0(SS))
D24/LTX: RN4.6 (2), SV2.9, U1.22 (PD5(XCK/CTS))
D+: RN1.5 (2), U1.4 (D+)
D-: RN1.8 (2), U1.3 (D-)
GND: C1.1, C2.1, C3.1, C4.-, C5.1, C6.1, C7.1, C8.1, C10.2, C11.1, C12.2, C14.-, D1.A, J1.7, J1.1.7, J5.3, Q1.2 (G2), Q1.4 (G1), RN4.7 (2), RN4.8 (2), S2.1, S2.3 (CH2), S2.4 (CH1), SV1.6, SV2.2, SV2.3, SV2.8, U1.5 (UGND), U1.15 (GND), U1.23 (GND1), U1.33 (PE2(!HWB)), U1.35 (GND2), U1.43 (GND3), U2.9 (GND), U3.1 (GND/ADJ), U4.2 (GND), U$5.P$4, U$5.P$5, X1.2, X3.P5 (GND), X3.S1 (SH1), X3.S2 (SH2), X3.S3 (SH3), X3.S4 (SH4), X3.S5 (SH5), X3.S6 (SH6), X4.GND, Z1.- (2)
IO8/A8: J1.1, J1.1.1, U1.28 (PB4(ADC11))
IO9*/A9: J1.2, J1.1.2, U1.29 (PB5(OC1A/ADC12/!OC4B))
IO10*/A10: J1.3, J1.1.3, U1.30 (PB6(OC1B/OC4B/ADC13))
IO11*: J1.4, J1.1.4, U1.12 (PB7(OC0A/OC1C/RTS)), U2.6 (I6)
IO12/A11: J1.5, J1.1.5, U1.26 (PD6(T1/ADC9/!OC4D))
IO13*: J1.6, J1.1.6, LED1.A, SJ2.1, SJ2.2, U1.32 (PC7(ICP3/CLK0/OC4A))
MD1: U2.14 (O5), XH2.P$5
MD2: U2.13 (O6), XH2.P$4
MD3: U2.12 (O7), XH2.P$3
MD4: U2.11 (O8), XH2.P$2
ME1: U2.18 (O1), XH1.P$5
ME2: U2.17 (O2), XH1.P$4
ME3: U2.16 (O3), XH1.P$3
ME4: U2.15 (O4), XH1.P$2
unnamed: LED5.C, RN4.1
unnamed: LED1.C, RN4.2 (1)
unnamed: LED4.C, RN4.3 (1)
unnamed: LED2.C, RN4.4 (1)
unnamed: F1.2, U$5.P$1, U$5.P$3 (S)
unnamed: C11.2, Q1.1 (X1), U1.16 (XTAL2)
unnamed: C12.1, Q1.3 (X2), U1.17 (XTAL1)
unnamed: JP2.2, Z1.+ (1)
unnamed: RN1.1, X3.P2 (D-)
unnamed: RN1.4 (1), X3.P3 (D+)
unnamed: U$5.P$2 (O), X1.1
RAW: C7.2, C14.+, D1.C, F1.1, SV2.1, U2.10 (CD+), U3.3 (IN), XH1.P$1, XH2.P$1
RESET: D3.A, R1.1, S2.2 (S), SV1.5, SV2.6, U1.13 (/RESET)
UCAP: C5.2, U1.6 (UCAP)
UVCC: C6.2, D2.2 (A), U1.2 (UVCC), U1.7 (VBUS), X3.P1 (VBUS)
VCC: C8.2, D3.C, J5.4, JP1.2, L1.1, R1.2, SV1.2, U1.14 (VCC), U1.34 (VCC1)

Notes on the sheet:
RXD
TXD
GND
VCC
00B
Por defecto ON
Creative commons. Attribution-ShareAlike 4.0 International (CC BY-SA 4.0)
Compatible Arduino Leonardo R3 Based,
