ionhs/Escornabot-2.12/Recopilación/electronics-master (2)/electronics-master/Cervus/cervus_2_0.brd

## EAGLE design Recopilación/electronics-master (2)/electronics-master/Cervus/cervus_2_0.brd (continued)

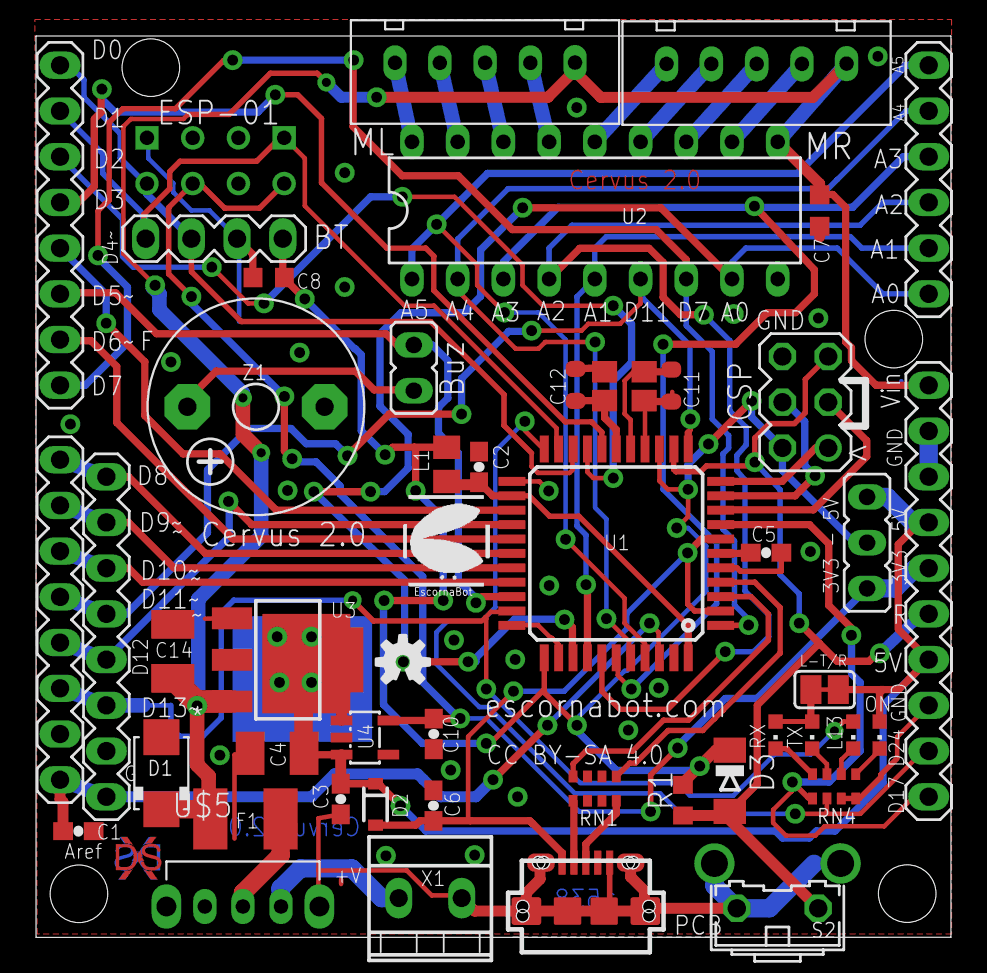
[picture p121: board cervus_2_0.brd from above]

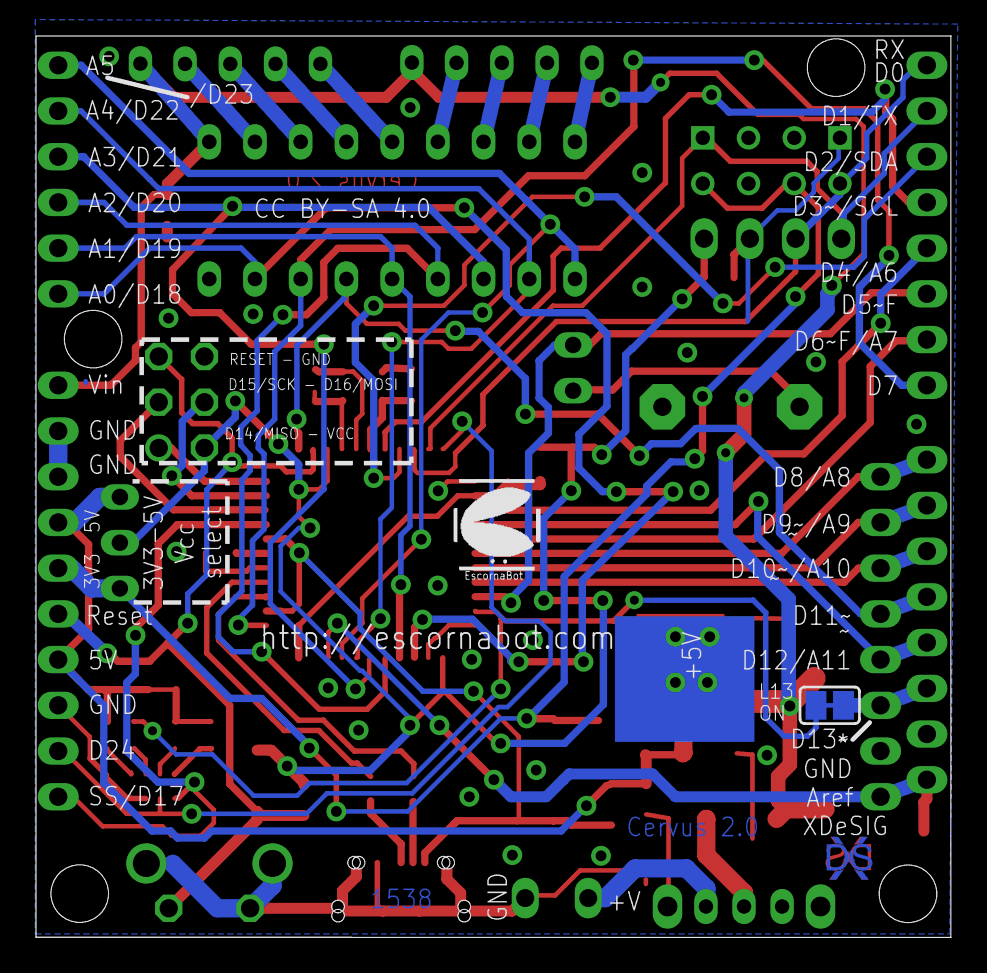
[picture p122: board cervus_2_0.brd from below]

Board: 2 copper layers, 50.8 x 50.1 mm, 53 parts (3 on the bottom side), 56 nets.
