ionhs/Escornabot-2.12/Recopilación/electronics-master (2)/electronics-master/EscornaCPU/1.x/1.0/Escorna_CPU_1_01.brd

## EAGLE design Recopilación/electronics-master (2)/electronics-master/EscornaCPU/1.x/1.0/Escorna_CPU_1_01.brd (2018-10-16)

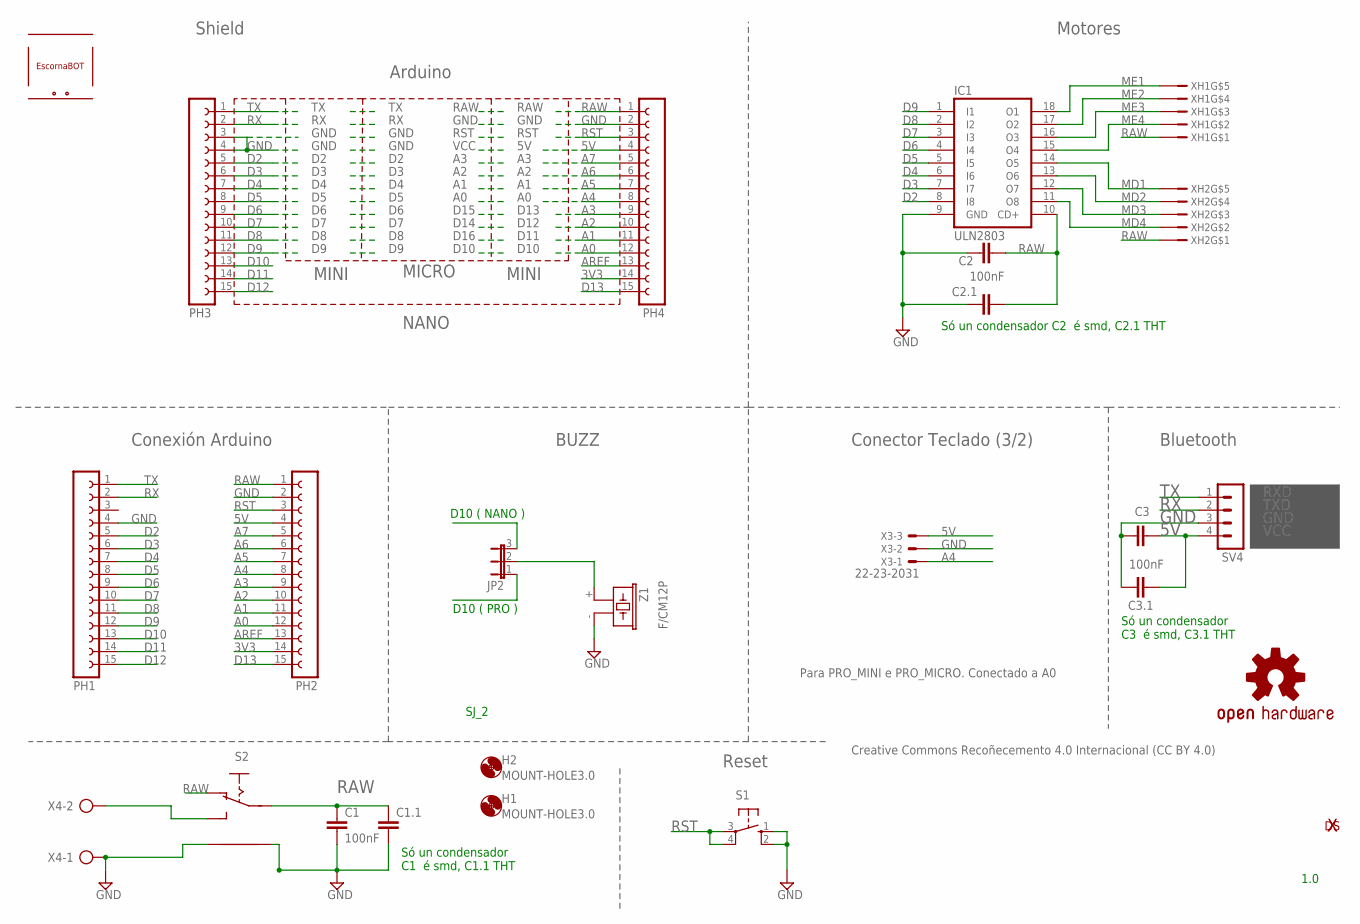
[picture p123: schematic Escorna_CPU_1_01.sch]

Parts:
C1, C2, C3: 100nF; C1206
C1.1, C2.1, C3.1: C-EU025-024X044; C025-024X044
H1, H2: MOUNT-HOLE3.0; 3,0
IC1: ULN2803; DIL18
JP2: JP2E; JP2
LOGO1: OSHW-LOGOS; OSHW-LOGO-S
PH1, PH2, PH3, PH4: FE15-1; FE15
S1: 10-XX; B3F-10XX
S2: SK12F14F; SK-12F14-G
SV4: MA04-1
U$1: ESCORNABOT; ESCORNA_PEQUE
U$6: XDESIG; XDESIG_CU_2
X3: 22-23-2031
X4: AK500/2
XH1, XH2: B5B-XH-A
Z1: F/CM12P

Connections:
3V3: PH2.14, PH4.14
5V: C3.2, C3.1.2, PH2.4, PH4.4, SV4.4, X3.3
A0: JP2.1, PH2.12, PH4.12
A1: PH2.11, PH4.11
A2: PH2.10, PH4.10
A3: PH2.9, PH4.9
A4: PH2.8, PH4.8, X3.1
A5: PH2.7, PH4.7
A6: PH2.6, PH4.6
A7: PH2.5, PH4.5
AREF: PH2.13, PH4.13
D2: IC1.8 (I8), PH1.5, PH3.5
D3: IC1.7 (I7), PH1.6, PH3.6
D4: IC1.6 (I6), PH1.7, PH3.7
D5: IC1.5 (I5), PH1.8, PH3.8
D6: IC1.4 (I4), PH1.9, PH3.9
D7: IC1.3 (I3), PH1.10, PH3.10
D8: IC1.2 (I2), PH1.11, PH3.11
D9: IC1.1 (I1), PH1.12, PH3.12
D10: JP2.3, PH1.13, PH3.13
D11: PH1.14, PH3.14
D12: PH1.15, PH3.15
D13: PH2.15, PH4.15
GND: C1.2, C1.1.2, C2.1, C2.1.1, C3.1, C3.1.1, IC1.9 (GND), PH1.4, PH2.2, PH3.3, PH3.4, PH4.2, S1.1 (S), S1.2 (S1), S2.P$4, S2.P$5, SV4.3, X3.2, X4.1, Z1.- (2)
MD1: IC1.14 (O5), XH2.P$5
MD2: IC1.13 (O6), XH2.P$4
MD3: IC1.12 (O7), XH2.P$3
MD4: IC1.11 (O8), XH2.P$2
ME1: IC1.18 (O1), XH1.P$5
ME2: IC1.17 (O2), XH1.P$4
ME3: IC1.16 (O3), XH1.P$3
ME4: IC1.15 (O4), XH1.P$2
unnamed: JP2.2, Z1.+ (1)
unnamed: S2.P$3 (S), X4.2
RAW: C1.1, C1.1.1, C2.2, C2.1.2, IC1.10 (CD+), PH2.1, PH4.1, S2.P$1, S2.P$2 (O), XH1.P$1, XH2.P$1
RST: PH2.3, PH4.3, S1.3, S1.4 (P1)
RX: PH1.2, PH3.2, SV4.2
TX: PH1.1, PH3.1, SV4.1

Notes on the sheet:
1.0
Conexión Arduino
Motores
Conector Teclado (3/2)
BUZZ
Bluetooth
RXD
TXD
GND
VCC
Reset
Para PRO_MINI e PRO_MICRO. Conectado a A0
D10 ( NANO )
D10 ( PRO )
SJ_2
Só un condensador C2 é smd, C2.1 THT
Só un condensador C3 é smd, C3.1 THT
Só un condensador C1 é smd, C1.1 THT
Shield
NANO
Arduino
MINI
MICRO
RAW
RST
D13
D15
D12
D14
D11
D16
D10
Creative Commons Recoñecemento 4.0 Internacional (CC BY 4.0)

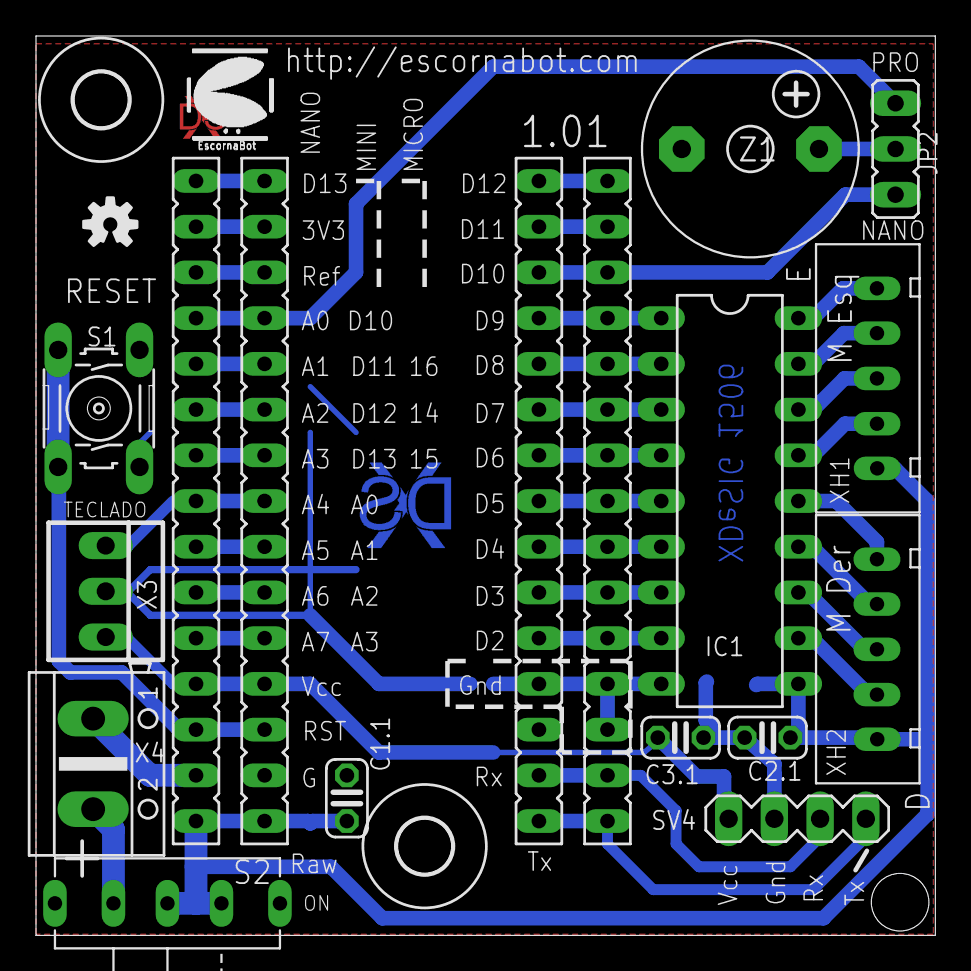
[picture p124: board Escorna_CPU_1_01.brd from above]

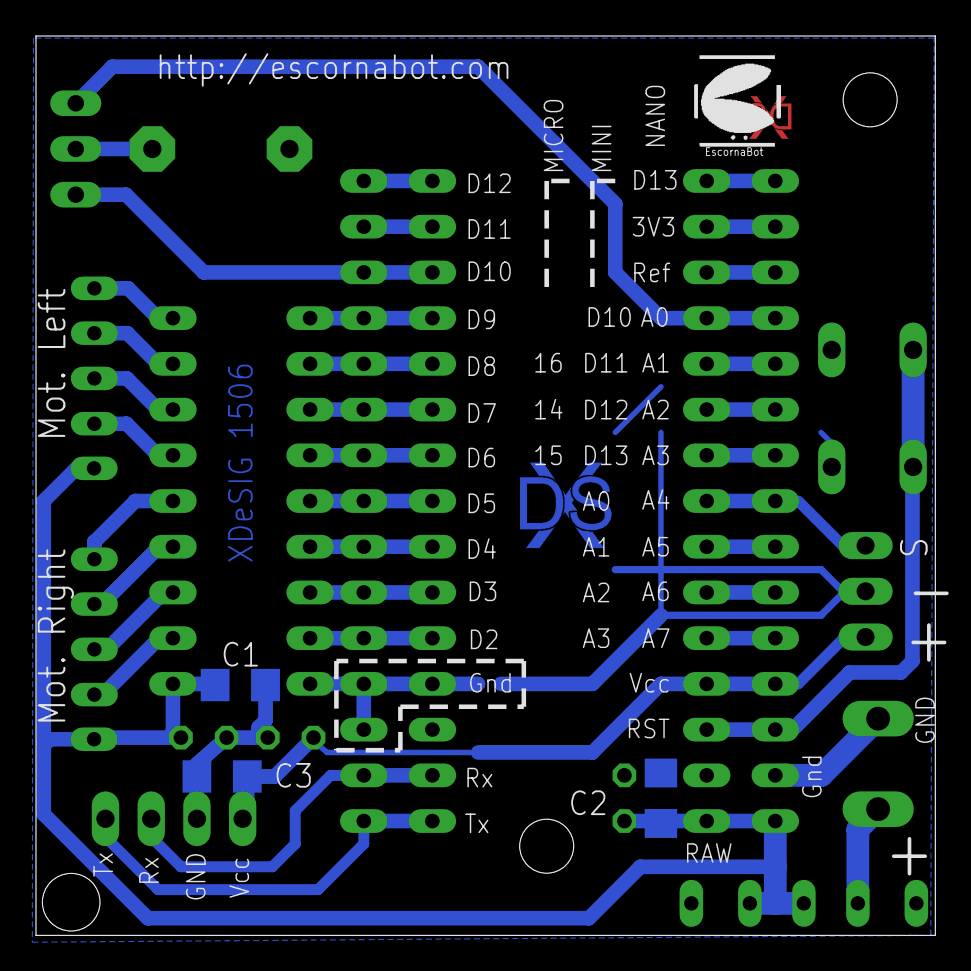
[picture p125: board Escorna_CPU_1_01.brd from below]

Board: 2 copper layers, 50.0 x 50.0 mm, 28 parts (5 on the bottom side), 38 nets.

Other parts of the board:
U$2, U$5: ESCORNABOT; ESCORNA_PEQUE
U$3: XDESIG; XDESIG_CU
