ionhs/Escornabot-2.12/Recopilación/electronics-master (2)/electronics-master/EscornaCPU/1.x/1.20/Escorna_CPU_1_20.brd

## EAGLE design Recopilación/electronics-master (2)/electronics-master/EscornaCPU/1.x/1.20/Escorna_CPU_1_20.brd (2018-10-16)

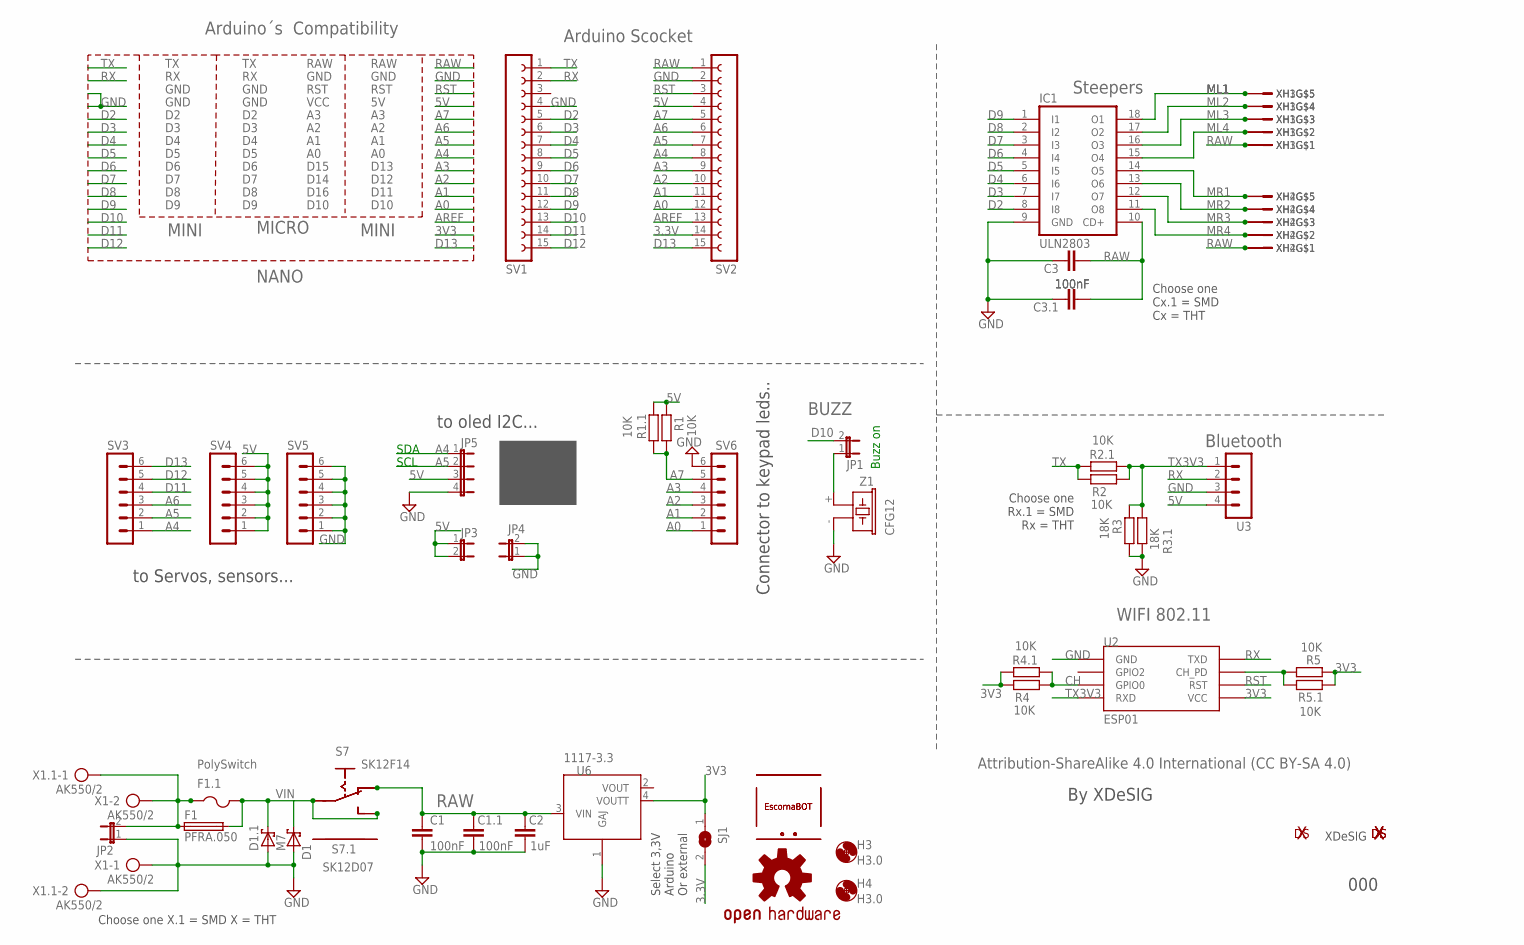
[picture p126: schematic Escorna_CPU_1_20.sch]

Parts:
C1, C3: 100nF; C025-025X050
C1.1, C3.1: 100nF; C0603K
C2: 1uF; C1206K
D1: 1N5817; DO41-10
D1.1: M7; SMA-DO214AC
ESC1, ESC2: ESCORNABOT; ESCORNA_PEQUE
F1: PFRA.050; TE5
F1.1: PolySwitch; R1206
H3, H4: H3.0; 3,0
IC1: ULN2803; DIL18
JP1, JP2: JP1E; 1X02
JP3, JP4: JP1E; JP1
JP5: JP4E; JP4
LOGO2: OSHW-LOGOS; OSHW-LOGO-S
R1, R2, R4, R5: 10K; 0204/7
R1.1, R2.1, R4.1, R5.1: 10K; R0603
R3: 18K; 0204/7
R3.1: 18K; R0603
S7: SK12F14; ESCORNA_SK-12F14-G
S7.1: SK12D07; ESCORNA_SK-12D07
SJ1: SJ
SV1, SV2: 1x15 SOCKET STRIP; CON-LSTA_FE15
SV3, SV4, SV5, SV6: MA06-1
U2: ESP01
U3: MA04-1
U6: 1117-3.3; SOT223
U$1, U$13: XDESIG_XDESIG21; XDESIG_XDESIG
X1, X1.1: AK550/2
XDS1: XDESIG; XDESIG_CU_2
XH1, XH2, XH3, XH4: B5B-XH-A
Z1: CFG12; F/CM12P

Connections:
3.3V: SJ1.2, SV2.14
3V3: R4.1, R4.1.1, R5.1, R5.1.1, SJ1.1, U2.VCC, U6.4 (VOUTT)
5V: JP3.1, JP3.2, JP5.3, R1.1, R1.1.1, SV2.4, SV4.1, SV4.2, SV4.3, SV4.4, SV4.5, SV4.6, U3.4
A0: SV2.12, SV6.1
A1: SV2.11, SV6.2
A2: SV2.10, SV6.3
A3: SV2.9, SV6.4
A4: JP5.1, SV2.8, SV3.1
A5: JP5.2, SV2.7, SV3.2
A6: SV2.6, SV3.3
A7: R1.2, R1.1.2, SV2.5, SV6.5
AREF: SV2.13
CH: R4.2, R4.1.2, U2.GPIO0
D2: IC1.8 (I8), SV1.5
D3: IC1.7 (I7), SV1.6
D4: IC1.6 (I6), SV1.7
D5: IC1.5 (I5), SV1.8
D6: IC1.4 (I4), SV1.9
D7: IC1.3 (I3), SV1.10
D8: IC1.2 (I2), SV1.11
D9: IC1.1 (I1), SV1.12
D10: JP1.2, SV1.13
D11: SV1.14, SV3.4
D12: SV1.15, SV3.5
D13: SV2.15, SV3.6
GND: C1.2, C1.1.1, C2.1, C3.1, C3.1.1, D1.A, D1.1.A, IC1.9 (GND), JP2.1, JP4.1, JP4.2, JP5.4, R3.2, R3.1.1, SV1.4, SV2.2, SV5.1, SV5.2, SV5.3, SV5.4, SV5.5, SV5.6, SV6.6, U2.GND, U3.3, U6.1 (GAJ), X1.1, X1.1.2, Z1.- (2)
ML1: IC1.18 (O1), XH1.P$5, XH3.P$5
ML2: IC1.17 (O2), XH1.P$4, XH3.P$4
ML3: IC1.16 (O3), XH1.P$3, XH3.P$3
ML4: IC1.15 (O4), XH1.P$2, XH3.P$2
MR1: IC1.14 (O5), XH2.P$5, XH4.P$5
MR2: IC1.13 (O6), XH2.P$4, XH4.P$4
MR3: IC1.12 (O7), XH2.P$3, XH4.P$3
MR4: IC1.11 (O8), XH2.P$2, XH4.P$2
unnamed: R5.2, R5.1.2, U2.CH_PD
unnamed: JP1.1, Z1.+ (1)
unnamed: F1.1, F1.1.1, JP2.2, X1.2, X1.1.1
unnamed: S7.P$4, S7.1.P$4
unnamed: S7.P$5, S7.1.P$5
RAW: C1.1, C1.1.2, C2.2, C3.2, C3.1.2, IC1.10 (CD+), S7.P$2 (O), S7.1.P$2 (O), SV2.1, U6.3 (VIN), XH1.P$1, XH2.P$1, XH3.P$1, XH4.P$1
RST: SV2.3, U2.RST
RX: SV1.2, U2.TX (TXD), U3.2
TX: R2.1, R2.1.1, SV1.1
TX3V3: R2.2, R2.1.2, R3.1, R3.1.2, U2.RX (RXD), U3.1
VIN: D1.C, D1.1.K (C), F1.2, F1.1.2, S7.P$1, S7.P$3 (S), S7.1.P$1, S7.1.P$3 (S)

Notes on the sheet:
Arduino Scocket
Steepers
BUZZ
Bluetooth
Buzz on
NANO
Arduino´s Compatibility
MINI
MICRO
GND
RAW
RST
VCC
D13
D15
D12
D14
D11
D16
D10
Attribution-ShareAlike 4.0 International (CC BY-SA 4.0)
WIFI 802.11
Choose one X.1 = SMD X = THT
XDeSIG
By XDeSIG
Choose one Cx.1 = SMD Cx = THT
000
SCL
SDA
Choose one Rx.1 = SMD Rx = THT
Select 3,3V Arduino Or external
Connector to keypad leds..
to oled I2C...
to Servos, sensors...

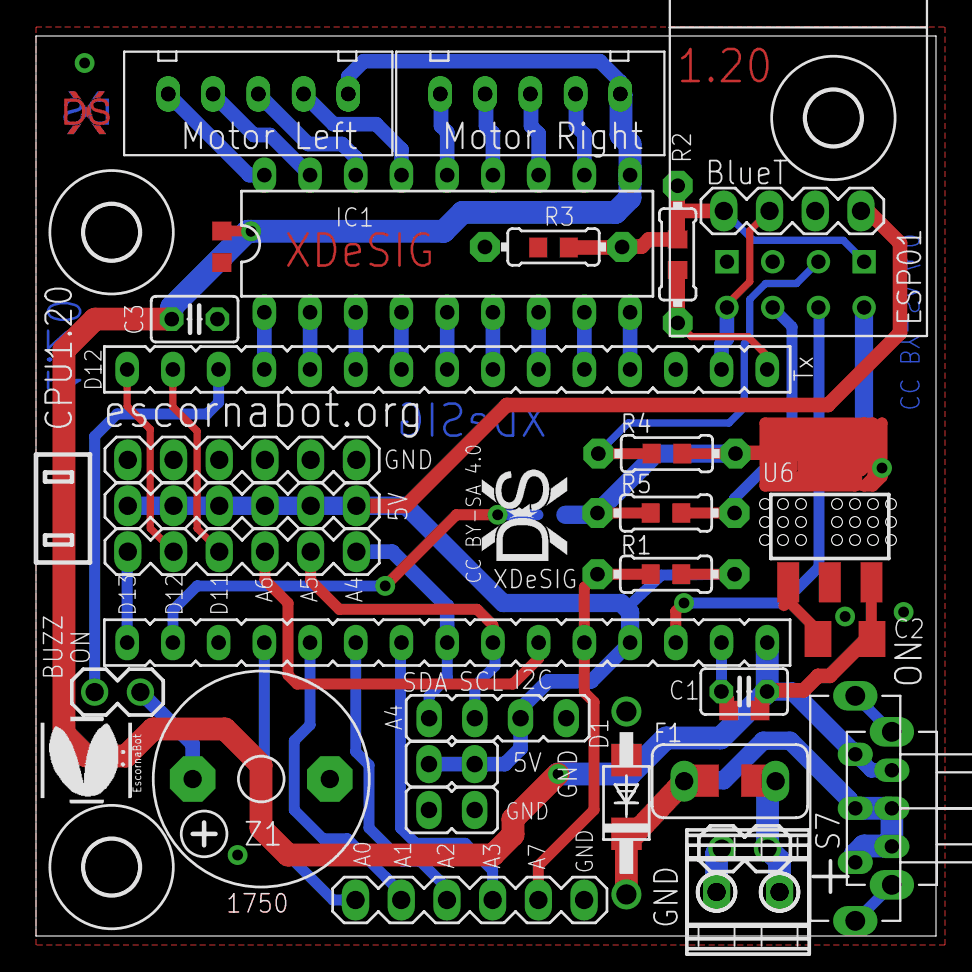
[picture p127: board Escorna_CPU_1_20.brd from above]

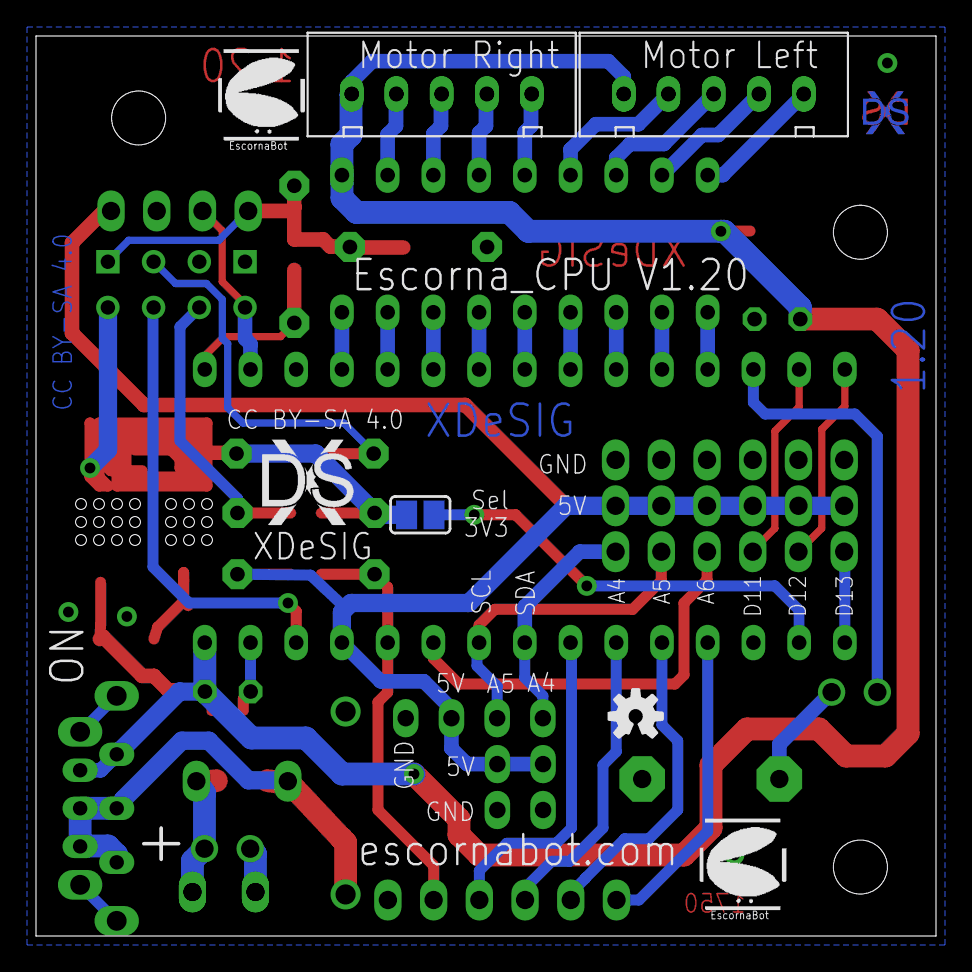
[picture p128: board Escorna_CPU_1_20.brd from below]

Board: 2 copper layers, 50.0 x 50.0 mm, 55 parts (8 on the bottom side), 44 nets.

Other parts of the board:
ESC: ESCORNABOT; ESCORNA_PEQUE
H7: MOUNT-HOLE3.0; 3,0
XDS: XDESIG; XDESIG_CU_2
