ionhs/Escornabot-2.12/(commit log)

2018-10-16 Actualización masiva
    [BotMotShielArdu.brd, BotMotShielArdu.sch, E_KEYPAD__2_1.brd, E_KEYPAD__2_1.sch, Escorna_CPU_1_01.brd, Escorna_CPU_1_01.sch, Escorna_CPU_1_20.brd, Escorna_CPU_1_20.sch]
2018-10-29 Añadido stl ultrasonido
2018-11-05 Actualización lista de componentes e instrucciones
    [Configuration.h]
