ionhs/Escornabot-2.12/(notices)

Notices in the files:
Software/arduino-1.4.3/arduino-1.4.3/Escornabot/Configuration.h:
modify it under the terms of the GNU General Public License
Recopilación/electronics-master (2)/electronics-master/EscornaCPU/2.x/2.12/Escorna_CPU_2_12.brd:
CC BY-SA 4.0 XDeSIG
parts and their libraries:
SparkFun-Aesthetics: Licensing: CC v3.0 Share-Alike You are welcome to use this library for commercial purposes.
